nunosousa/SCART-switcher/CAD/fan-4010-orion-fan-od4010-24hb01a-1.snapshot.2/Screenshot 2024-12-19 at 11.23.29 PM.png

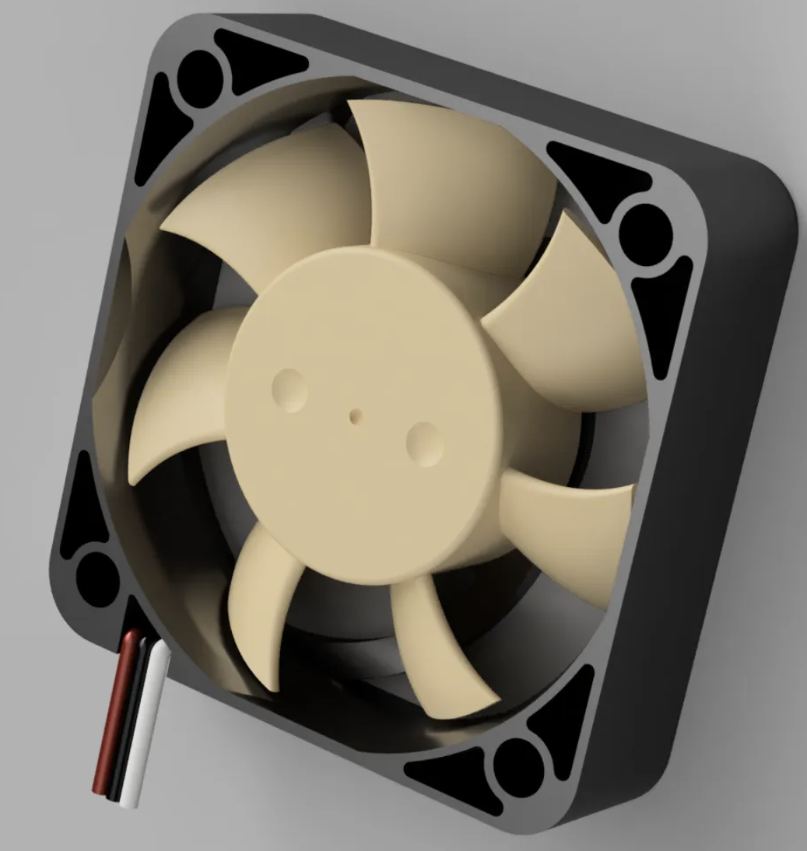
CAD/fan-4010-orion-fan-od4010-24hb01a-1.snapshot.2/Screenshot 2024-12-19 at 11.23.29 PM.png
