nunosousa/SCART-switcher/ECAD/Power_supply/Power_supply_bottom.png

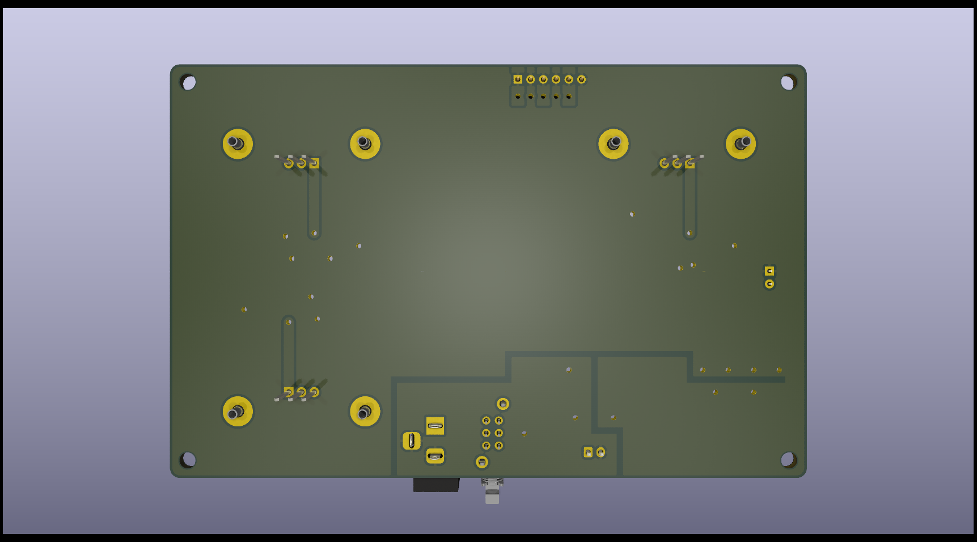
ECAD/Power_supply/Power_supply_bottom.png
