nunosousa/SCART-switcher/ECAD/SCART_switcher/SCART_switcher_bottom.png

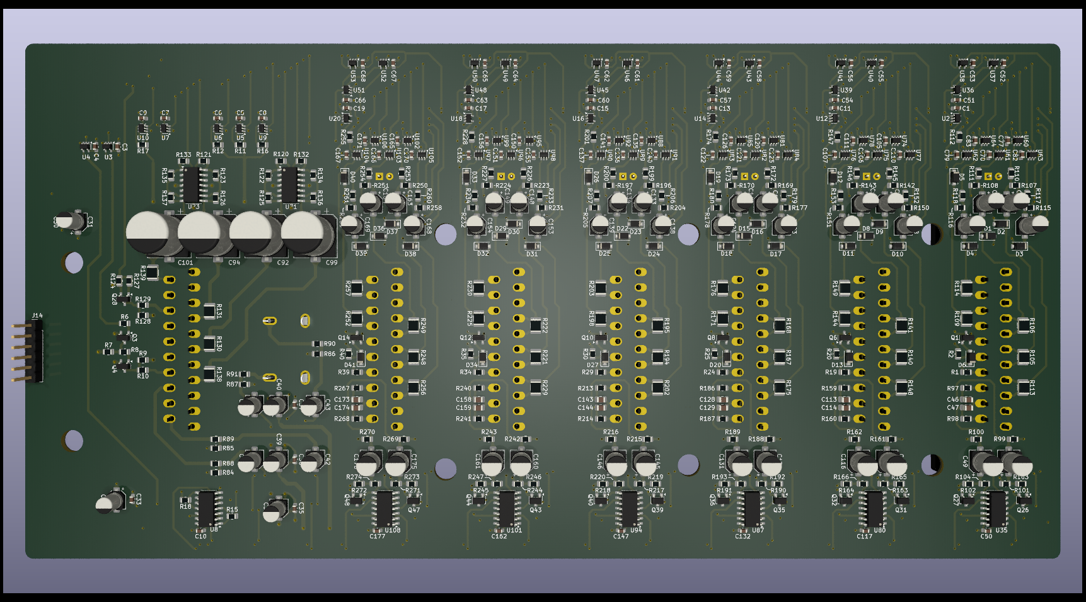
ECAD/SCART_switcher/SCART_switcher_bottom.png
