nunosousa/SCART-switcher/ECAD/SCART_switcher/LM4041.xlsx

 | Select R1 and R2 to get VO. Also get IR (V divider) and IL (load). |  |  |  | With IQ (0.1mA ≤ lQ ≤ 1mA) and VS, get Rs and Itotal. |  |  |  |  | Vref correction.
5V in, 2.5V out | Vref (V) | 1.230466 | VO (V) | 2.491189361 | IQ (A) | 0.00105 | Rs (ohm) | 522.4606912 | 523 | VY (V)* | 1.233
 | R1 (ohm) | 976 | VO error (mV) | -8.810639344 |  |  | PD (W) | 0.002615748829 |  | ΔVREF/ΔVO) (V/V)* | -0.002
 | R2 (ohm) | 1000 | IR (A) | 0.001260723361 | VS (V) | 5 |  |  |  | Desired VO (V)* | 2.5
 |  |  |  |  |  |  |  |  |  | ΔVO (V) | 1.267
 | RL (ohm) | 1000 | IL (A) | 0.002491189361 | Itotal (A) | 0.004801912721 |  |  |  | Vref (V) | 1.230466
9V in, 4.5V out | Vref (V) | 1.226466 | VO (V) | 4.505786856 | IQ (A) | 0.00105 | Rs (ohm) | 682.7813485 | 681 | VY (V)* | 1.233
 | R1 (ohm) | 374 | VO error (mV) | 5.786855615 |  |  | PD (W) | 0.004731076198 |  | ΔVREF/ΔVO) (V/V)* | -0.002
 | R2 (ohm) | 1000 | IR (A) | 0.003279320856 | VS (V) | 9 |  |  |  | Desired VO (V)* | 4.5
 |  |  |  |  |  |  |  |  |  | ΔVO (V) | 3.267
 | RL (ohm) | 2000 | IL (A) | 0.002252893428 | Itotal (A) | 0.006582214283 |  |  |  | Vref (V) | 1.226466
 | OK |  |  |  |  |  |  |  |  | OK
 |  |  |  |  |  |  |  |  |  |  |  | *See LM4041 ADJ datasheet.
