nunosousa/SCART-switcher/CAD/5mm standoff.FCStd

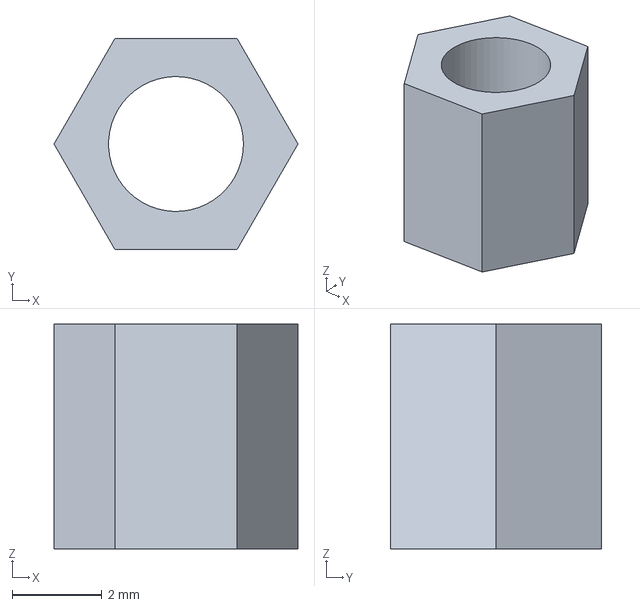
[picture p6: CAD file, 2025-02-28]
CAD/5mm standoff.FCStd
5.43 x 4.70 x 5.00 mm
