nunosousa/SCART-switcher/CAD/fan-4010-orion-fan-od4010-24hb01a-1.snapshot.2/fan-4010-orion-fan-od4010-24hb01a.step

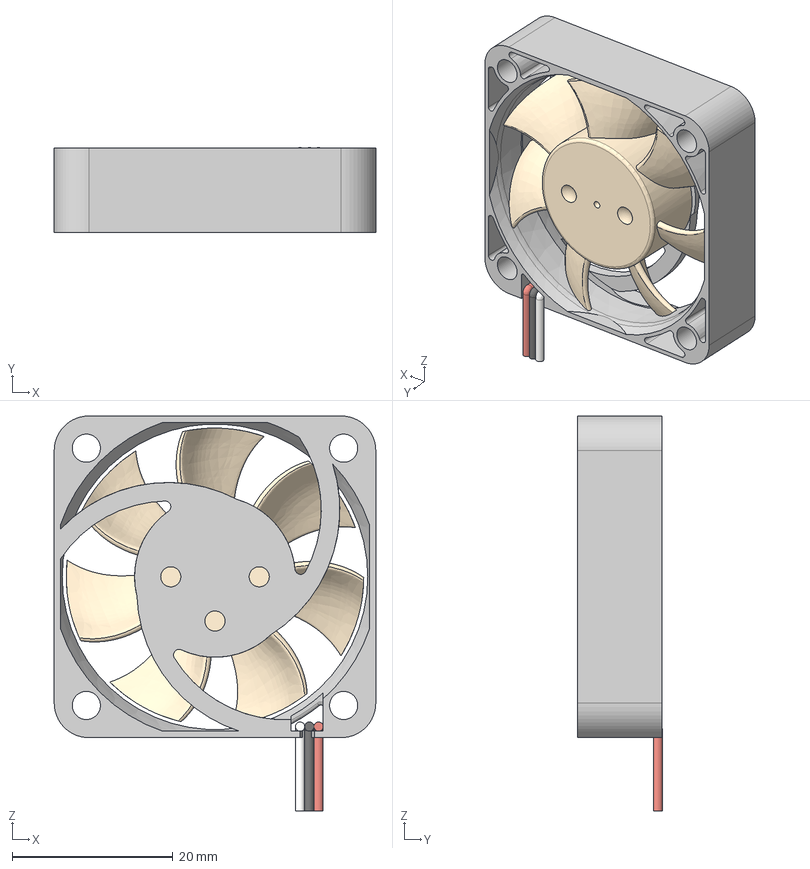
[picture p7: CAD file, 2025-02-23]
CAD/fan-4010-orion-fan-od4010-24hb01a-1.snapshot.2/fan-4010-orion-fan-od4010-24hb01a.step
40.0 x 10.6 x 49.1 mm
Orion Blades_40x40 v3
Wire-Red
Wire-Black
Wire-White
