nunosousa/SCART-switcher/ECAD/Power_supply/Power_supply.step

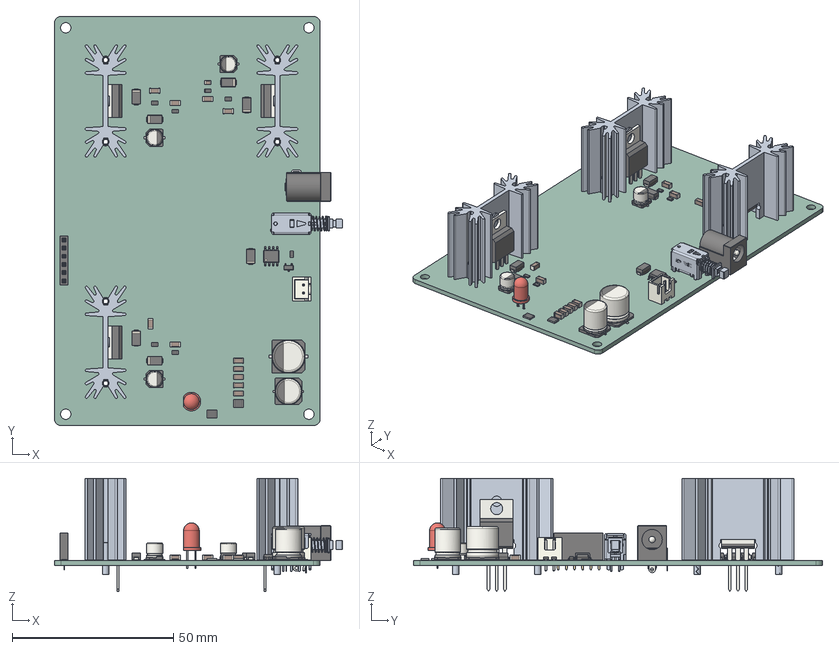
[picture p8: CAD file, 2025-02-27]
ECAD/Power_supply/Power_supply.step
89.4 x 127.0 x 35.1 mm
C_1206_3216Metric x 11
D_SMA x 7
SOIC_8_39x49mm_P127mm
R_0805_2012Metric x 7
CP_Elec_5x54 x 3
JST_B2B_XH_A
R_1210_3225Metric x 2
LED_D5.0mm
PinSocket_1x06_P2.54mm_Vertical
CP_Elec_10x105
SOT_23
TO-220-3_Vertical x 3
=>[0:1:1:2] x 3
=>[0:1:1:4] x 3
=>[0:1:1:6] x 3
C_0805_2012Metric
BarrelJack_Horizontal
CP_Elec_8x10
_autosave-Power_supply_PCB
