nunosousa/SCART-switcher/ECAD/SCART_switcher/SCART_switcher.step

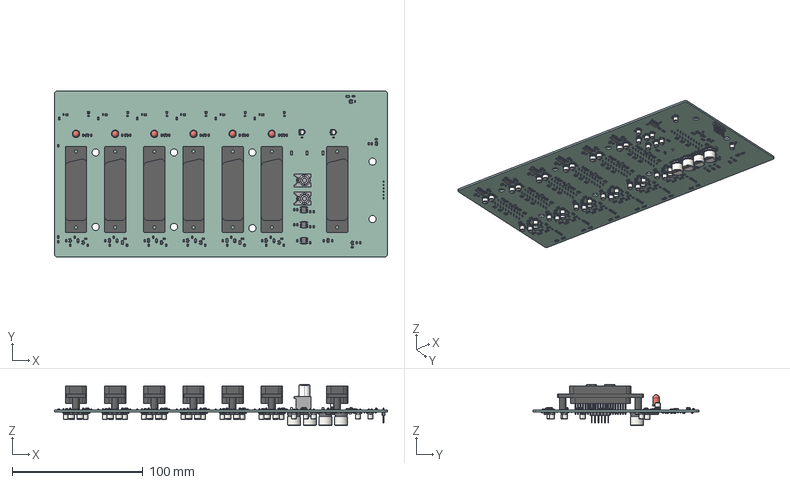
[picture p9: CAD file, 2025-02-27]
ECAD/SCART_switcher/SCART_switcher.step
255.0 x 127.0 x 31.7 mm
R_0805_2012Metric x 219
D_SOD_123F x 43
SOT_23 x 28
C_1206_3216Metric x 4
SOT_353_SC_70_5 x 38
SOT_23_5
C_0603_1608Metric x 88
SOIC_8_39x49mm_P127mm x 3
LED_D5.0mm x 6
SOT-23-3 x 2
CP_Elec_4x54 x 11
R_1210_3225Metric x 34
CP_Elec_4x58 x 24
SOT_363_SC_70_6 x 35
CP_Elec_10x105 x 4
SC_59 x 12
CP_Elec_5x54 x 12
C_0805_2012Metric x 12
SOIC_14_39x87mm_P127mm x 9
PinHeader_1x06_P254mm_Vertical
SCART_switcher_PCB
