nunosousa/SCART-switcher/CAD/35mm standoff.FCStd

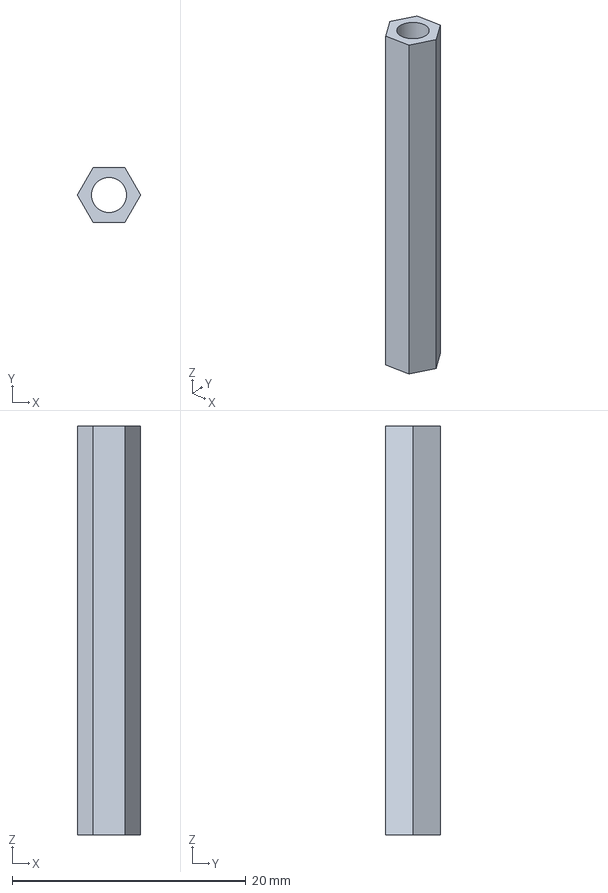
[picture p10: CAD file, 2025-02-25]
CAD/35mm standoff.FCStd
5.43 x 4.70 x 35.0 mm
