nunosousa/SCART-switcher/CAD/SCART connector with m holes (female)-Body.step

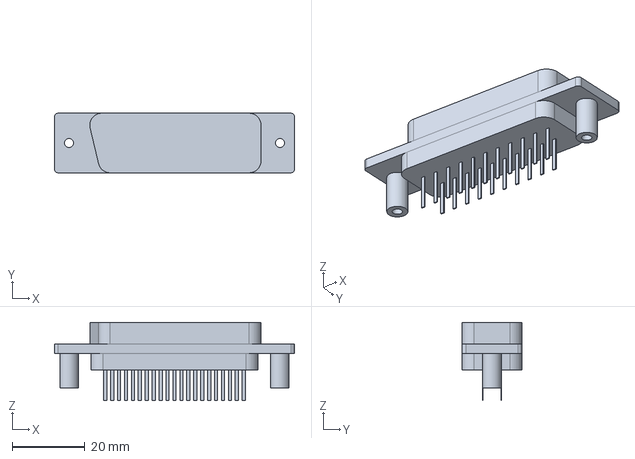
[picture p11: CAD file, 2025-02-23]
CAD/SCART connector with m holes (female)-Body.step
66.0 x 16.4 x 21.5 mm
