nunosousa/SCART-switcher/CAD/sk_104_25.4_stc.igs

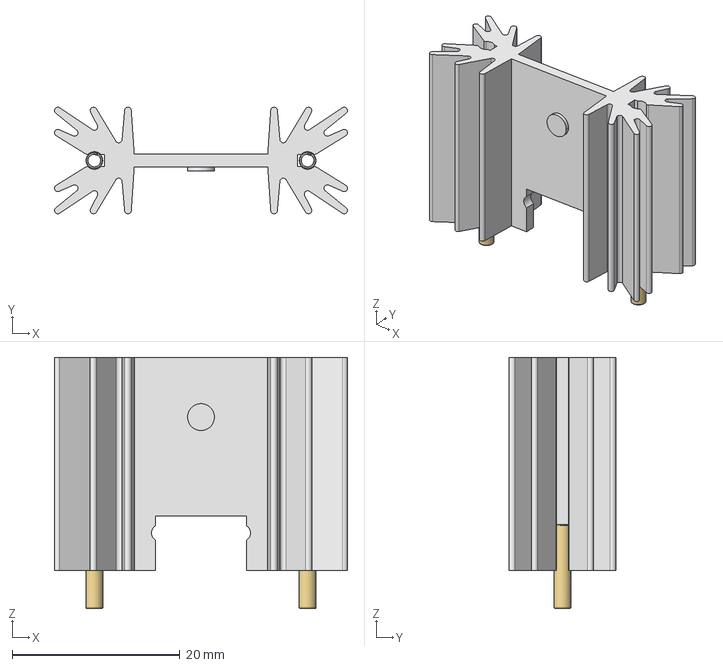
[picture p12: CAD file, 2025-02-16]
CAD/sk_104_25.4_stc.igs
34.9 x 12.7 x 29.9 mm
