nunosousa/SCART-switcher/CAD/sk_104_25.4_stic.igs

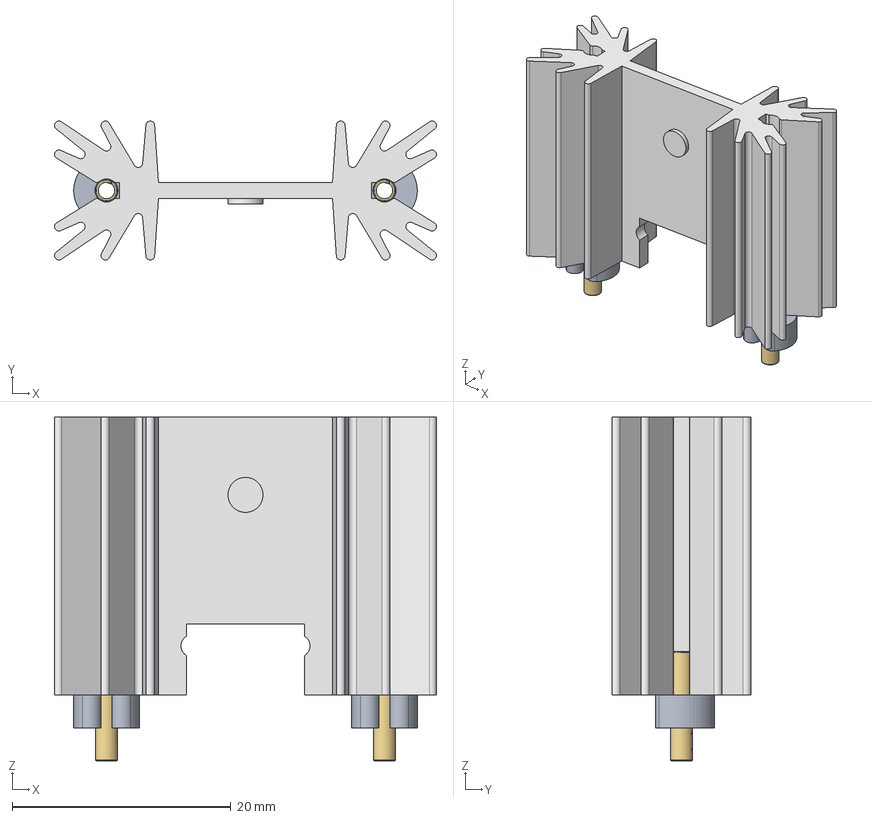
[picture p13: CAD file, 2025-02-16]
CAD/sk_104_25.4_stic.igs
34.9 x 12.7 x 31.4 mm
