nunosousa/SCART-switcher/CAD/SCART connector (female)-Body.iges

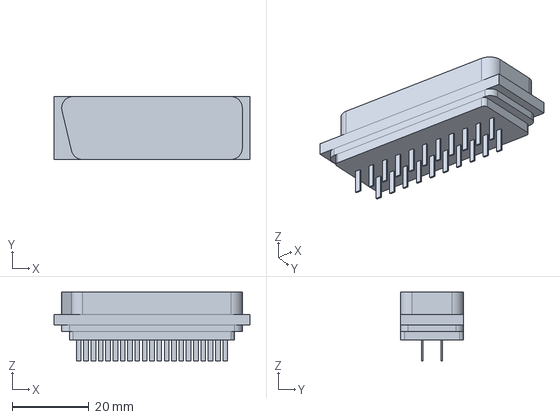
[picture p14: CAD file, 2023-08-15]
CAD/SCART connector (female)-Body.iges
51.0 x 16.4 x 17.9 mm
