nunosousa/SCART-switcher/(list of files, cad)

Other CAD files:
CAD/SCART connector with m holes (female).FCStd
CAD/SCART connector (female).FCStd
CAD/SCART connector with m holes (female)-Body.iges
CAD/fan-4010-orion-fan-od4010-24hb01a-1.snapshot.2/fan-4010-orion-fan-od4010-24hb01a.f3d
CAD/fan-4010-orion-fan-od4010-24hb01a-1.snapshot.2/fan-4010-orion-fan-od4010-24hb01a.iges
