nunosousa/SCART-switcher/ECAD/Power_supply/Power_supply.pdf

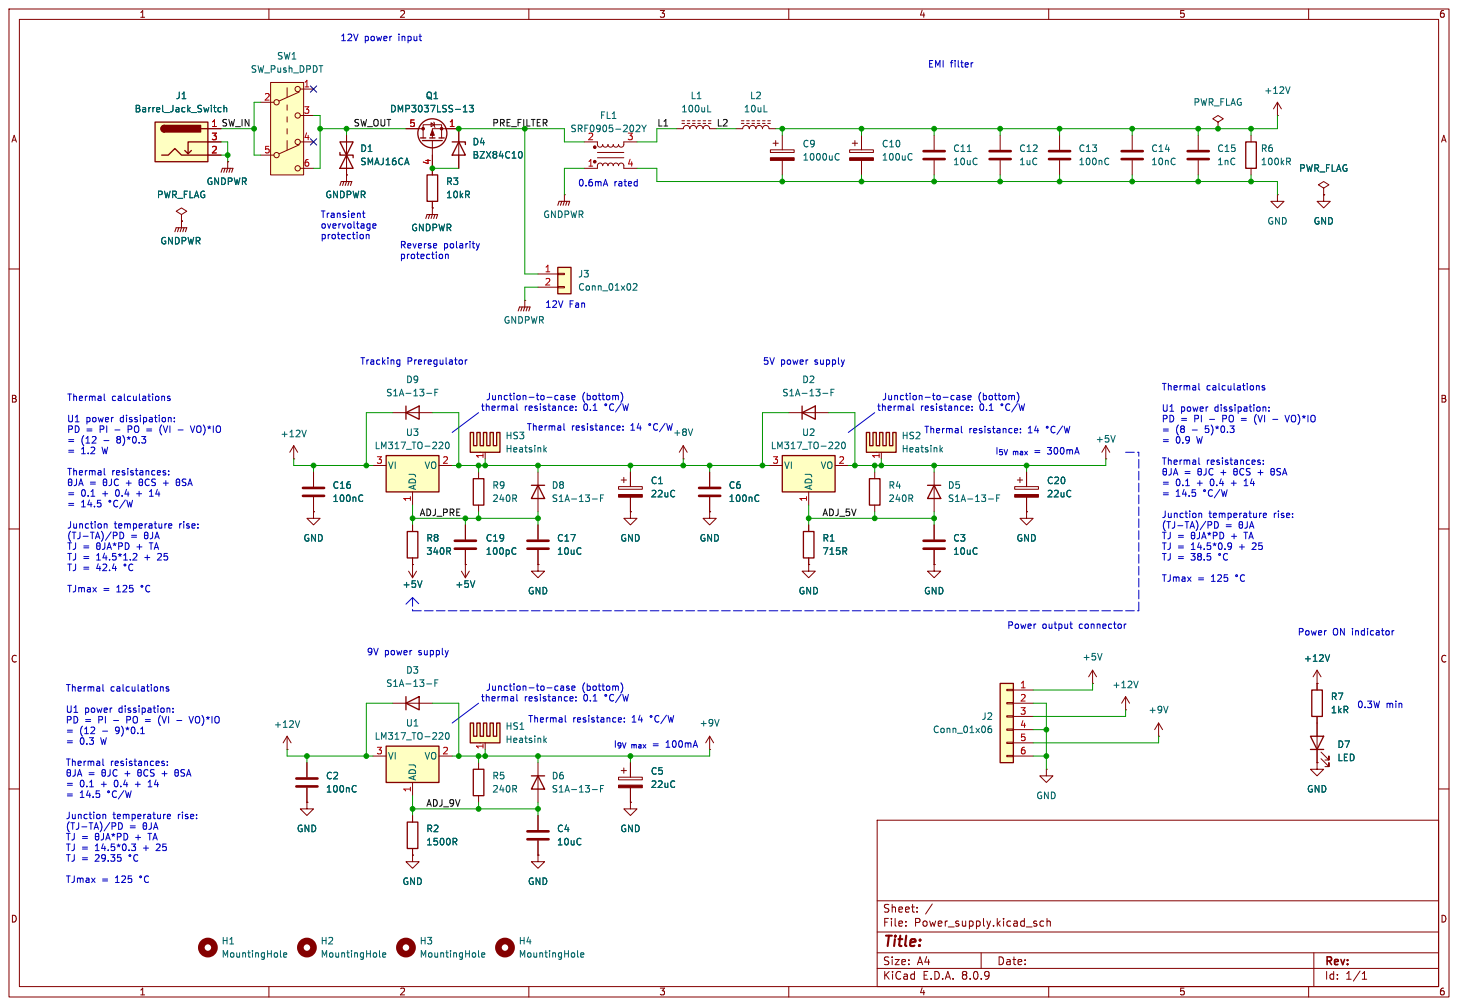
[picture p15: page 1]

5V power supply Thermal calculations U1 power dissipation: PD = PI - PO = (VI - VO)*IO

Thermal resistances: þÿ¸JA= þÿ¸JC+ þÿ¸CS+ þÿ¸SA

0.3W min Thermal calculations U1 power dissipation: PD = PI - PO = (VI - VO)*IO
