nunosousa/SCART-switcher/ECAD/SCART_switcher/SCART_switcher.pdf

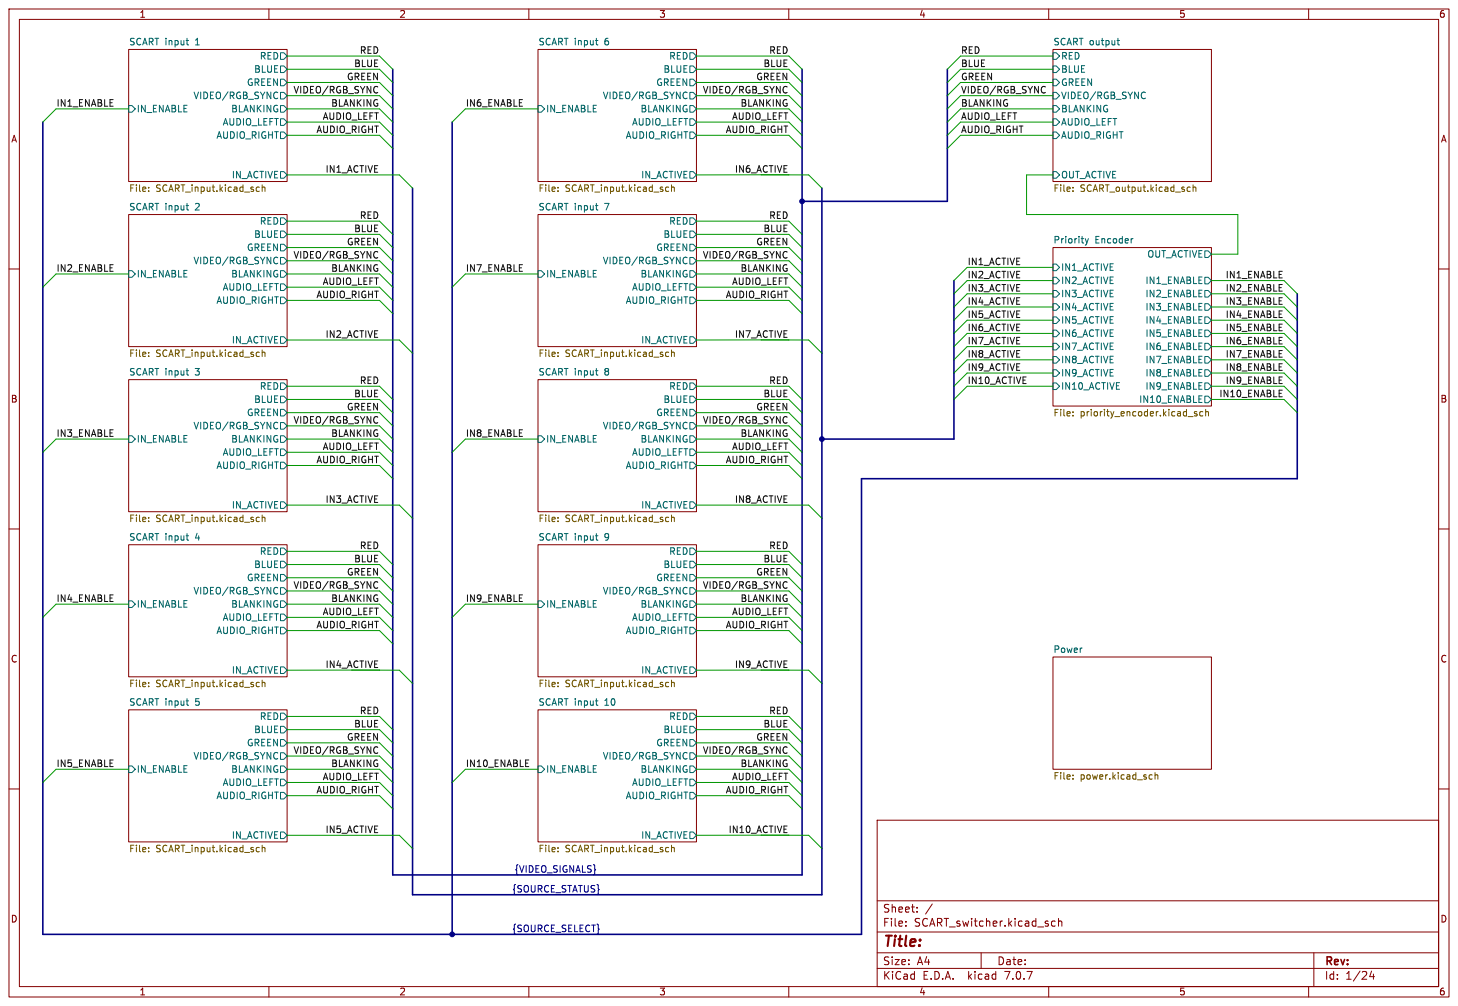
[picture p16: page 1]

SCART input 9 File: SCART_input.kicad_sch BLUE
RED

Id: 1/24 Title: File: SCART_switcher.kicad_sch Sheet: /

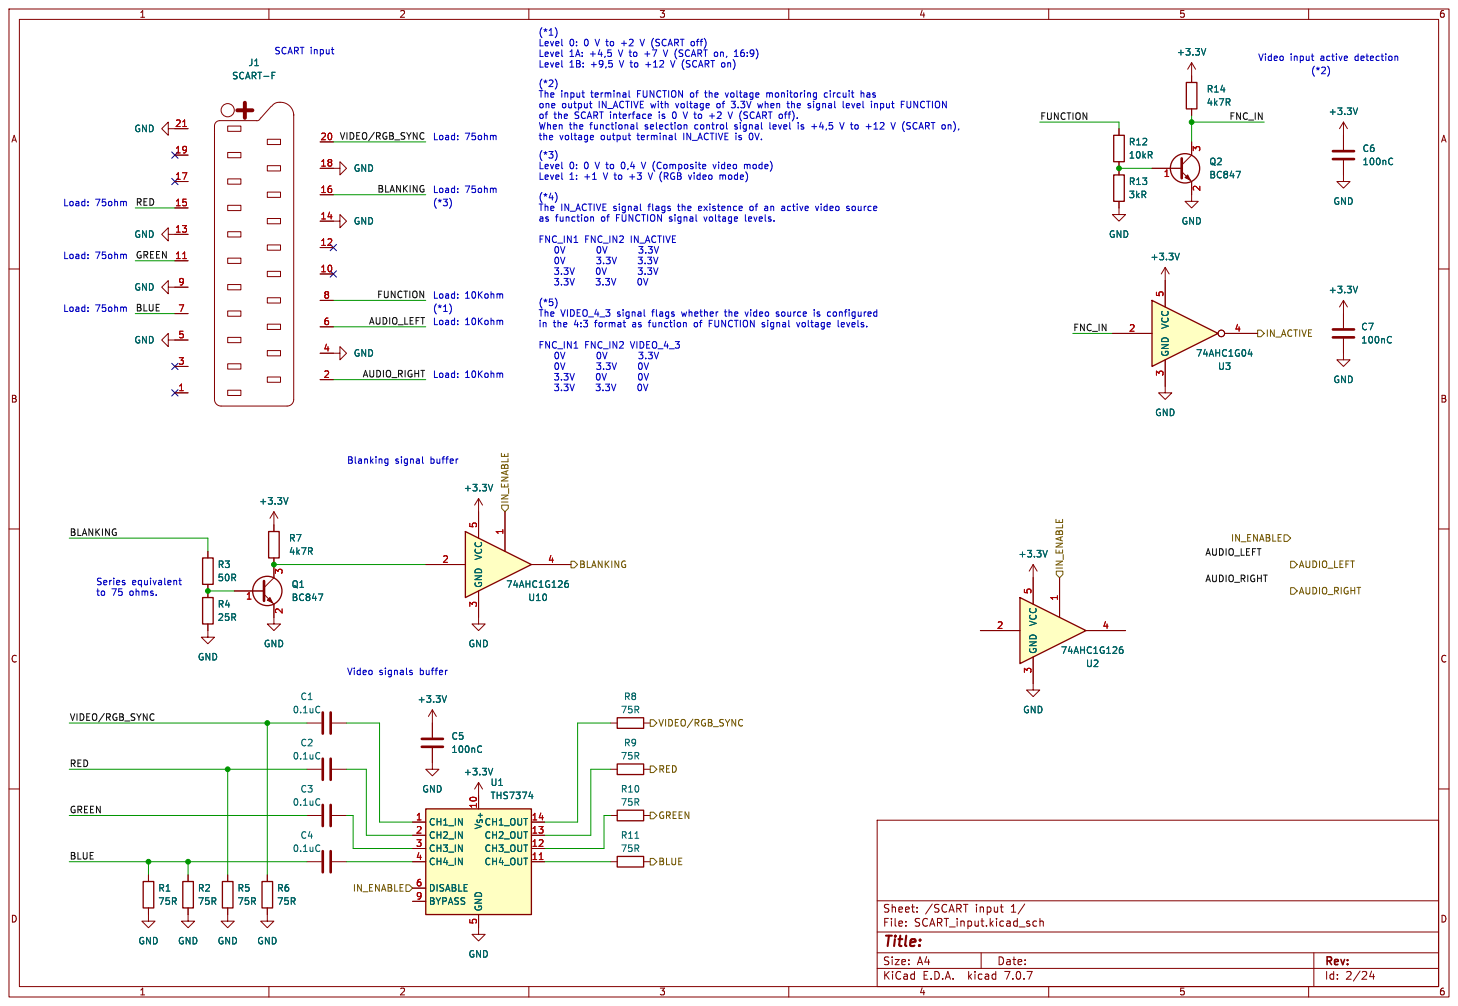
[picture p17: page 2]

(*1) Level 0: 0 V to +2 V (SCART off) Level 1A: +4,5 V to +7 V (SCART on, 16:9) Level 1B: +9,5 V to +12 V (SCART on)
(*1) Load: 75ohm

FUNCTION GREEN
+3.3V GND GND GND GND

(*5) The VIDEO_4_3 signal flags whether the video source is configured

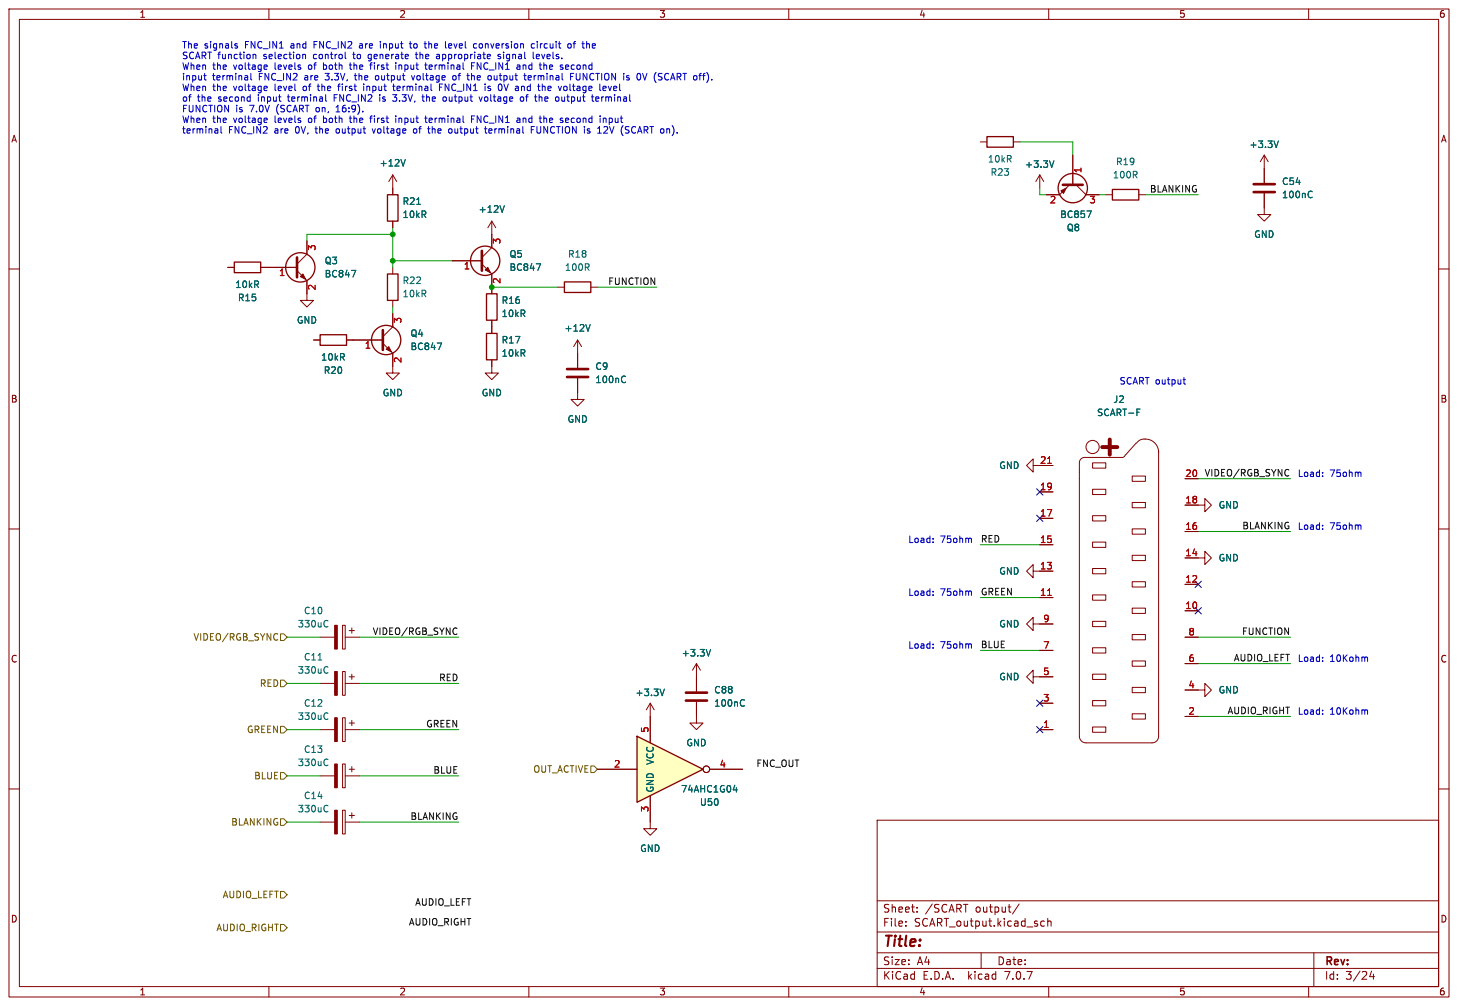
[picture p18: page 3]

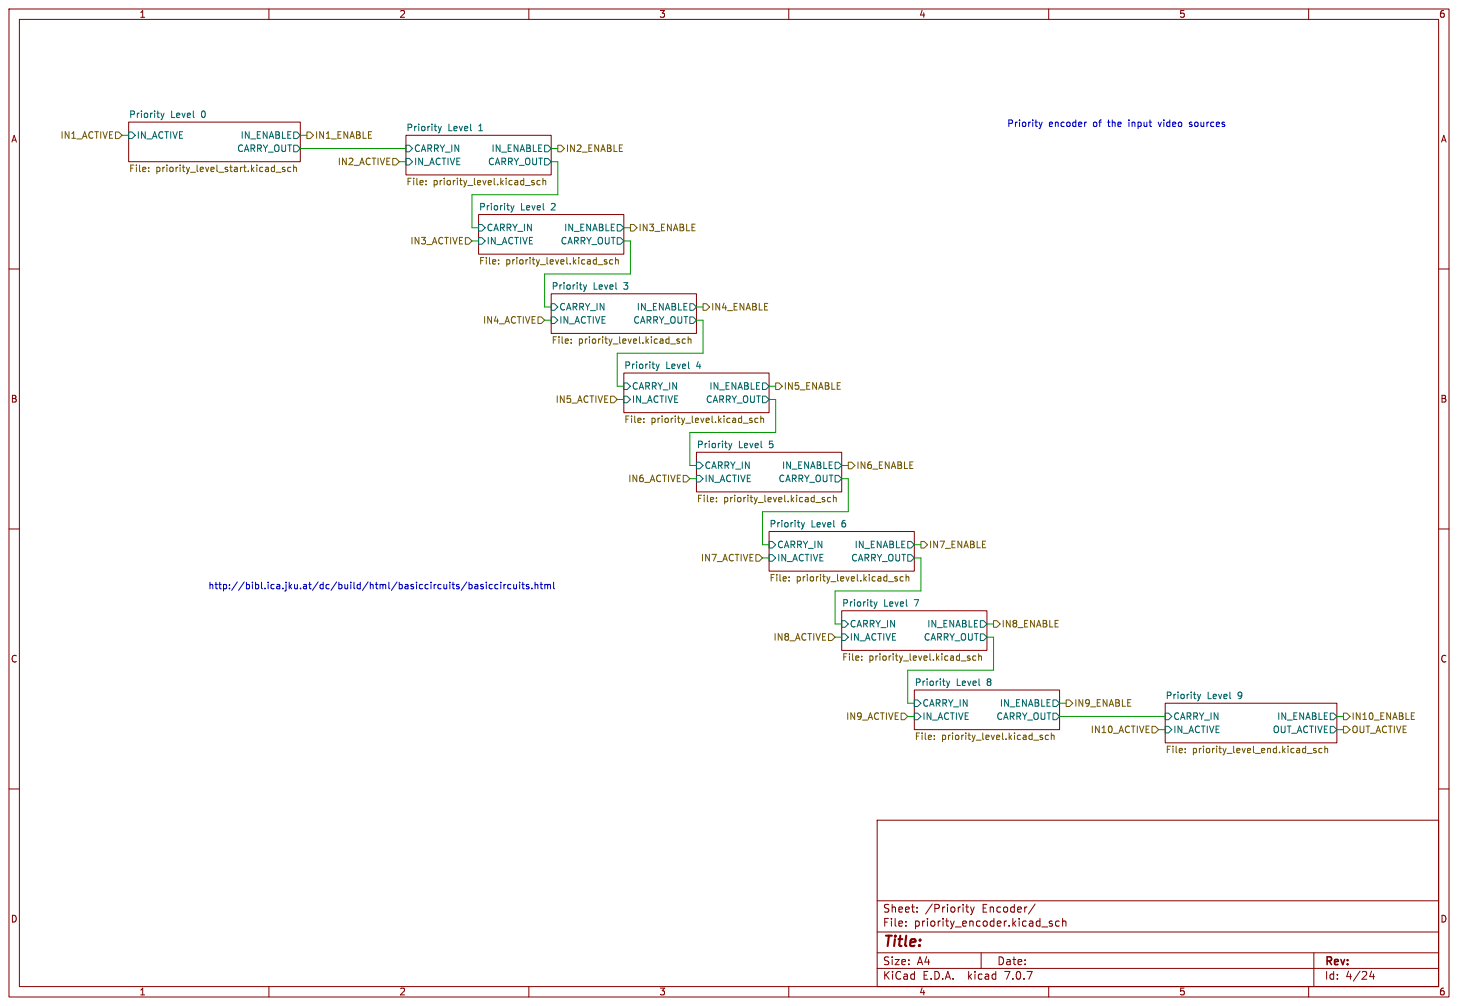
[picture p19: page 4]

http://bibl.ica.jku.at/dc/build/html/basiccircuits/basiccircuits.html

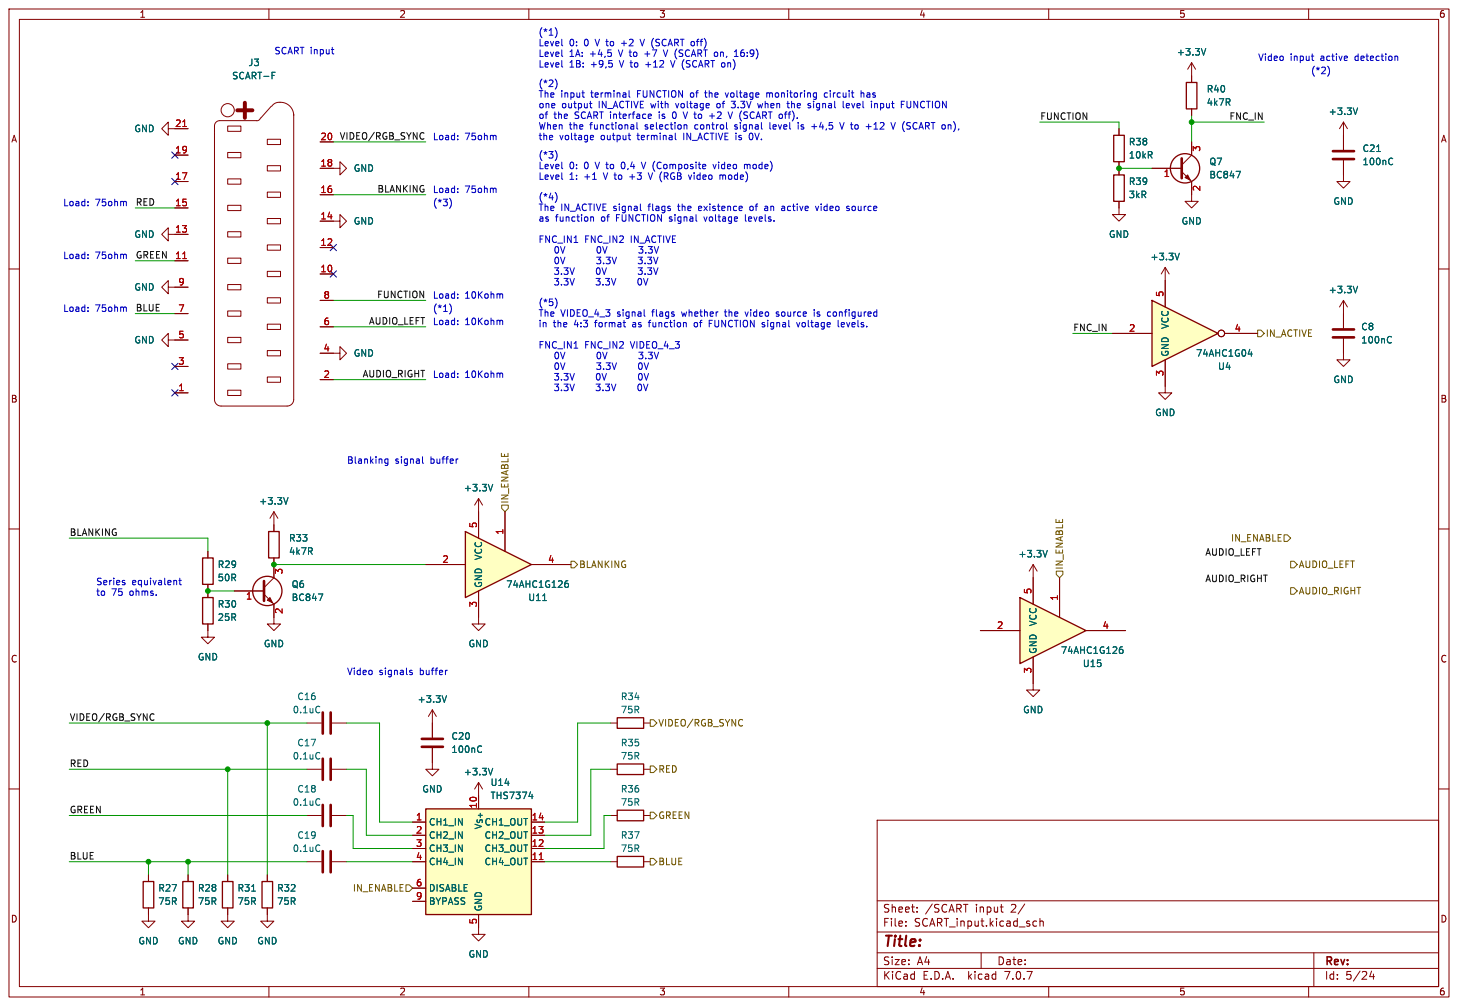
[picture p20: page 5]
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

(*5) The VIDEO_4_3 signal flags whether the video source is configured

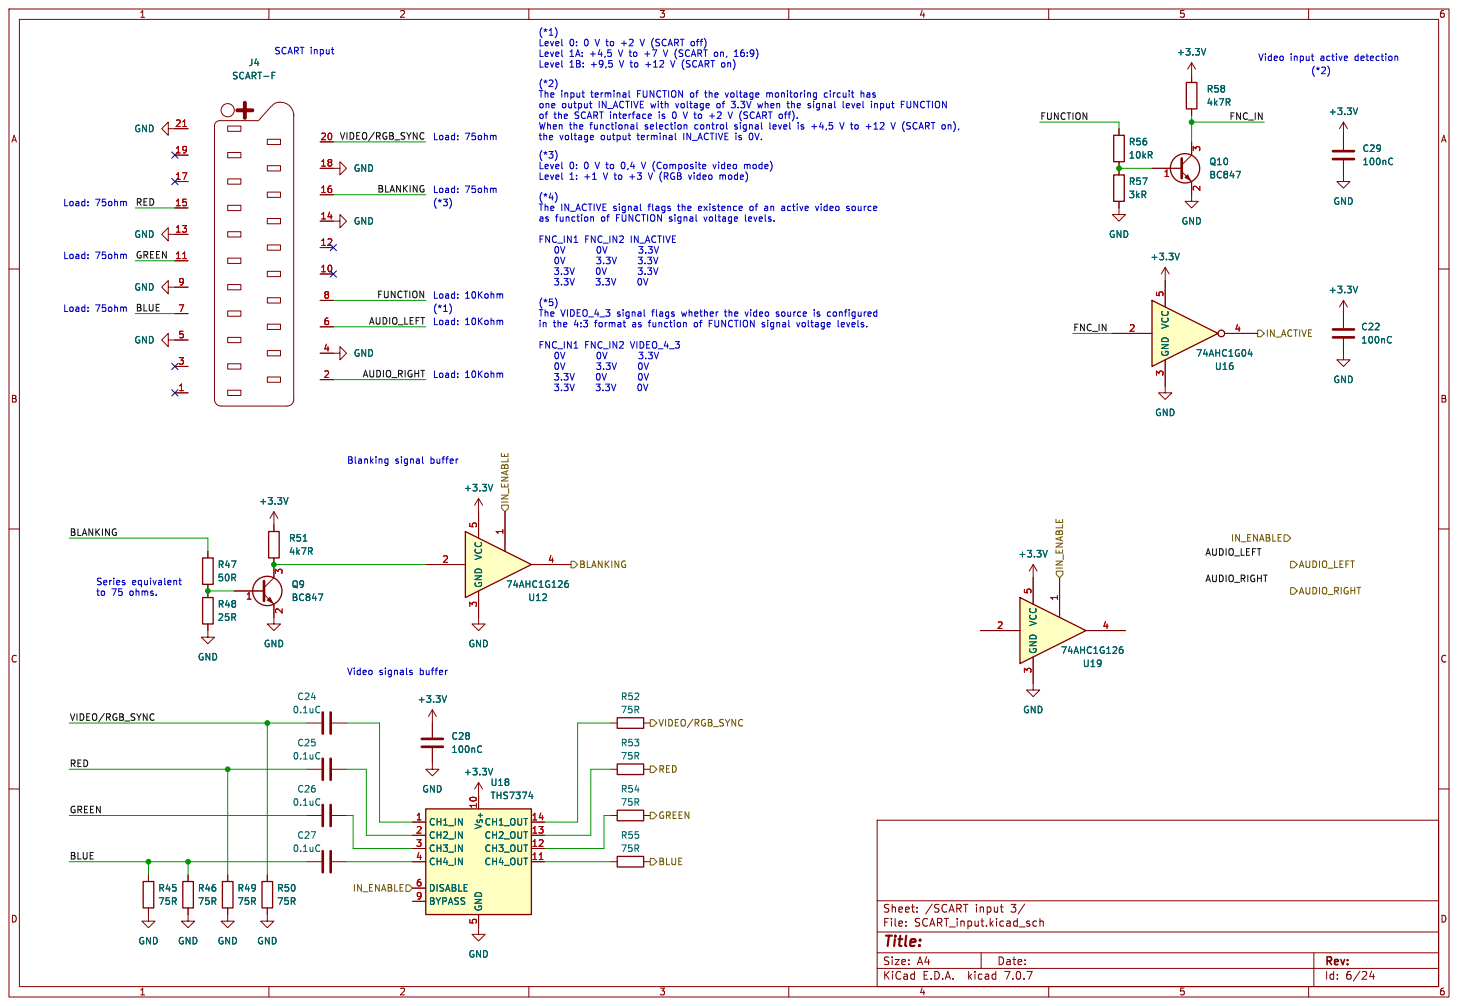
[picture p21: page 6]
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

(*5) The VIDEO_4_3 signal flags whether the video source is configured

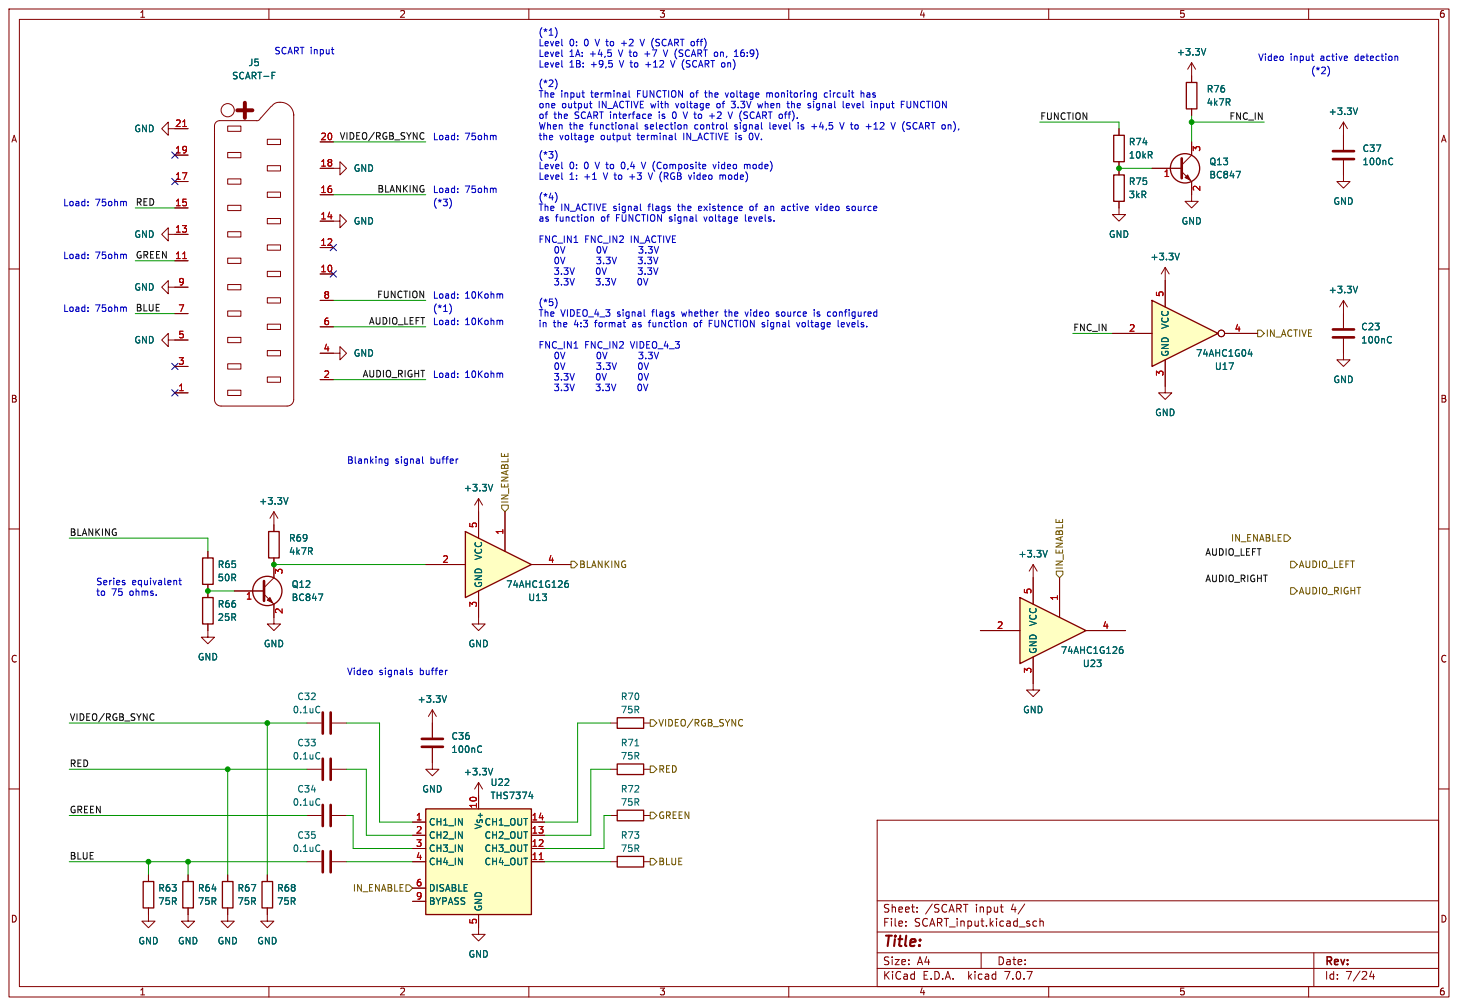
[picture p22: page 7]
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

(*5) The VIDEO_4_3 signal flags whether the video source is configured

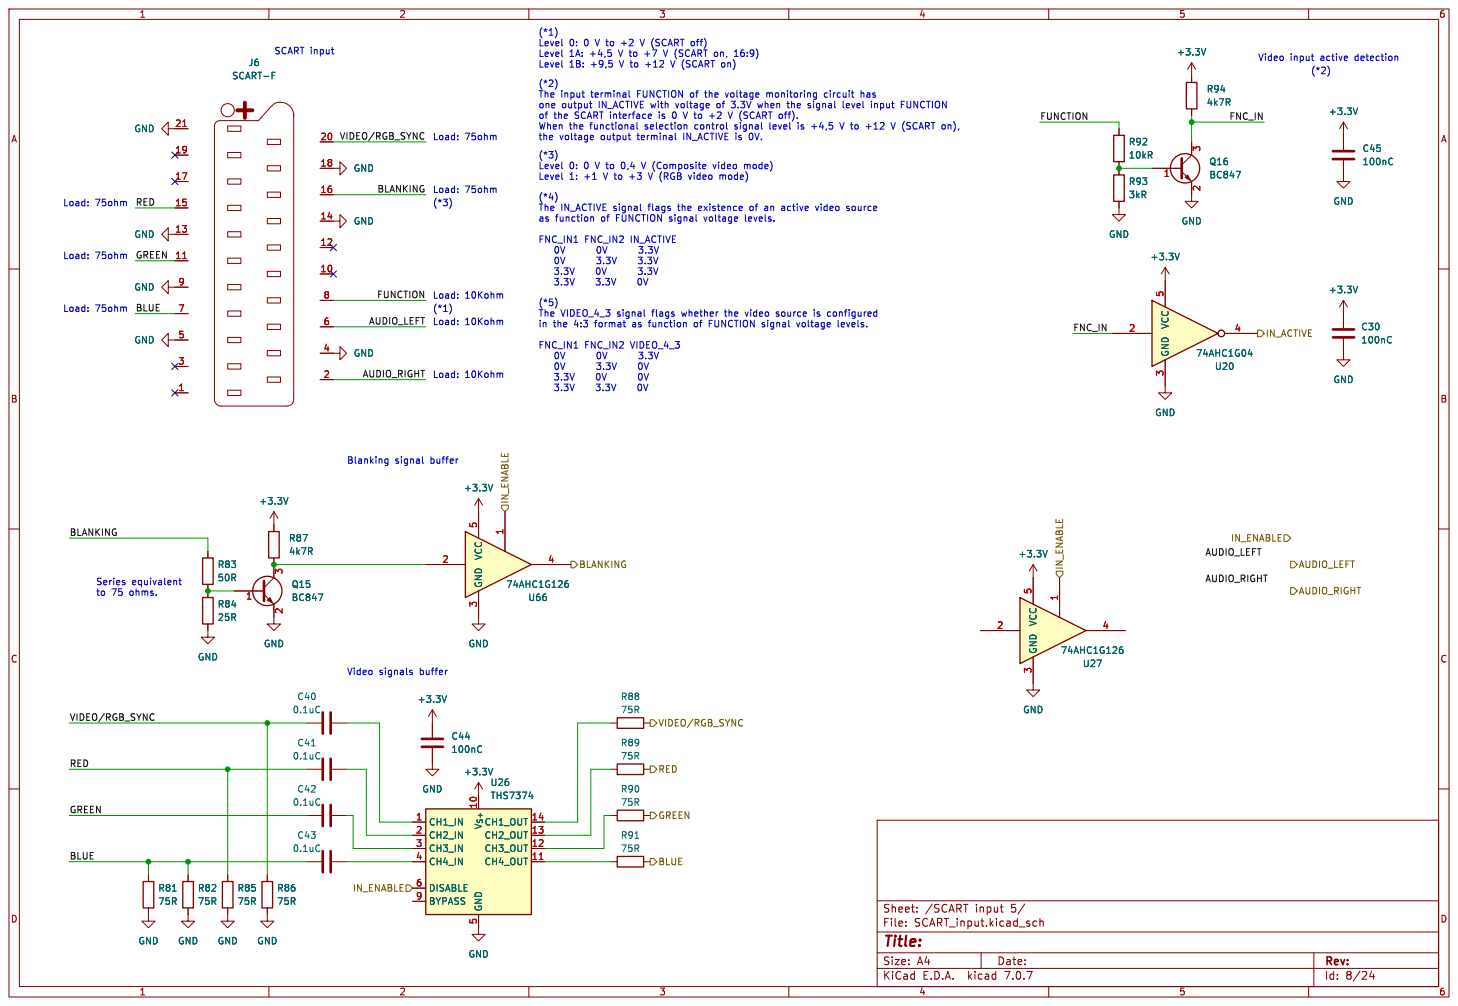
[picture p23: page 8]
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

FUNCTION GREEN
+3.3V GND GND GND GND

(*5) The VIDEO_4_3 signal flags whether the video source is configured

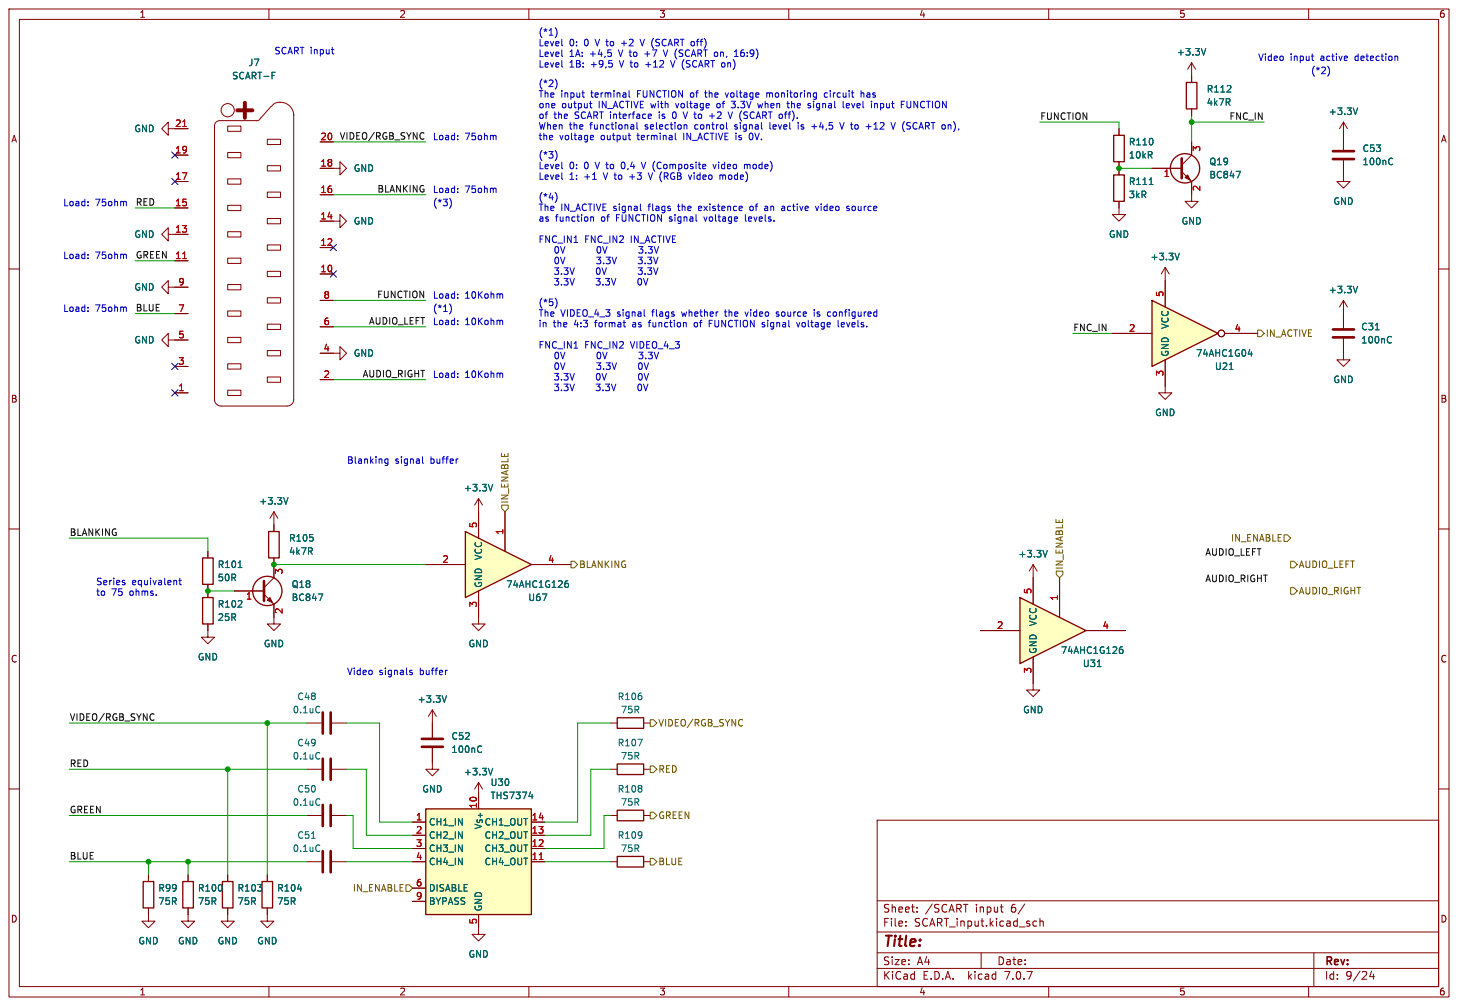
[picture p24: page 9]
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

(*5) The VIDEO_4_3 signal flags whether the video source is configured

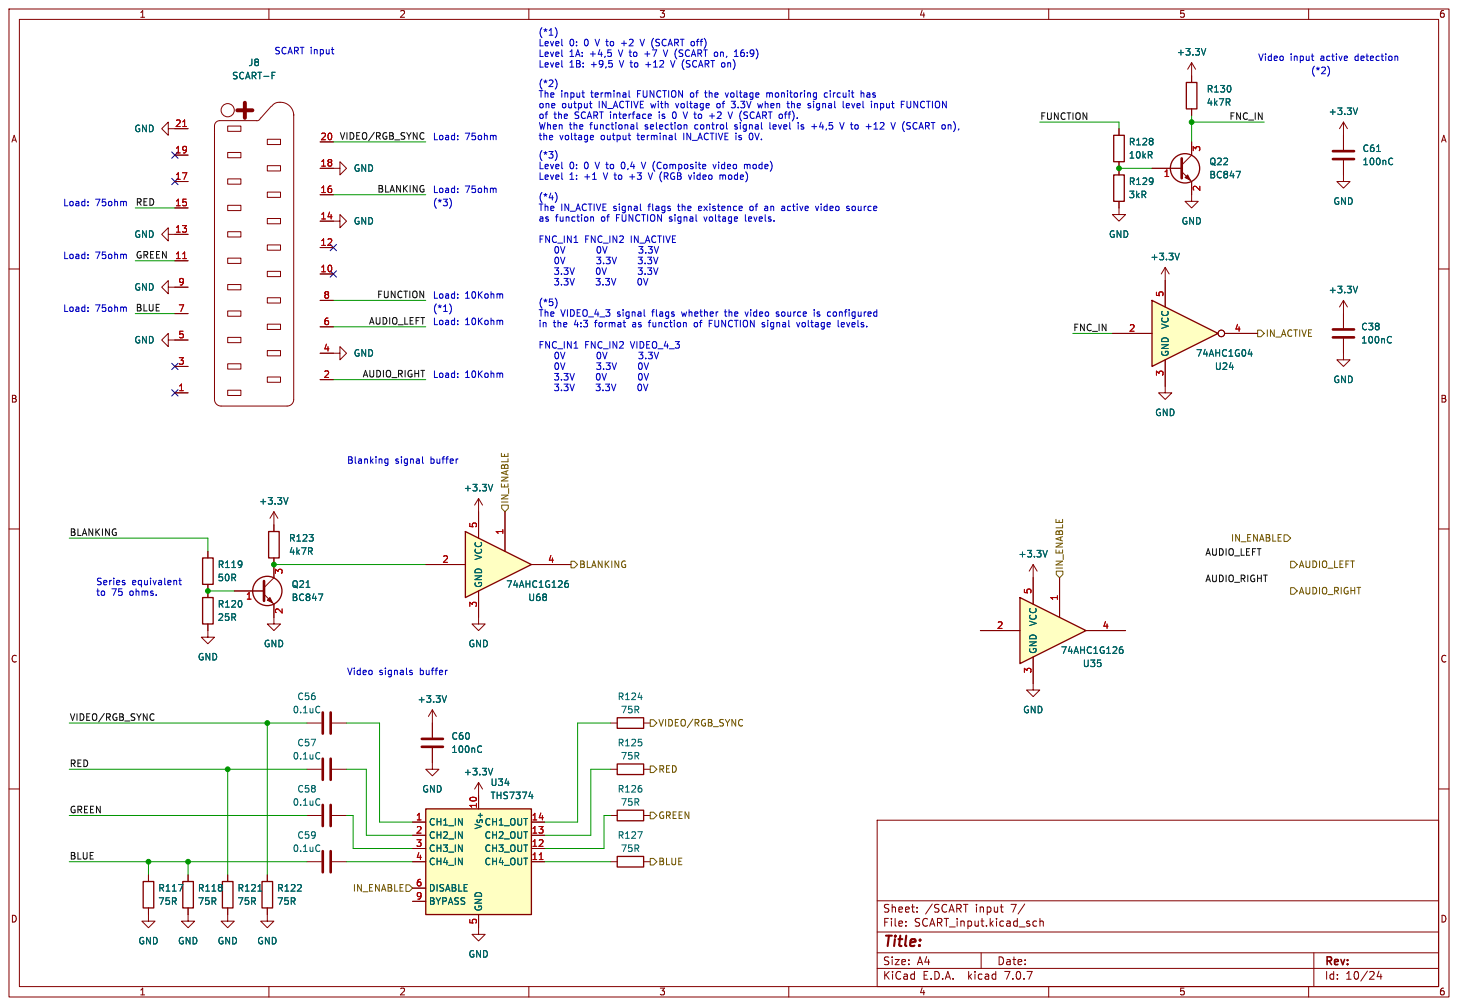
[picture p25: page 10]
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

(*5) The VIDEO_4_3 signal flags whether the video source is configured

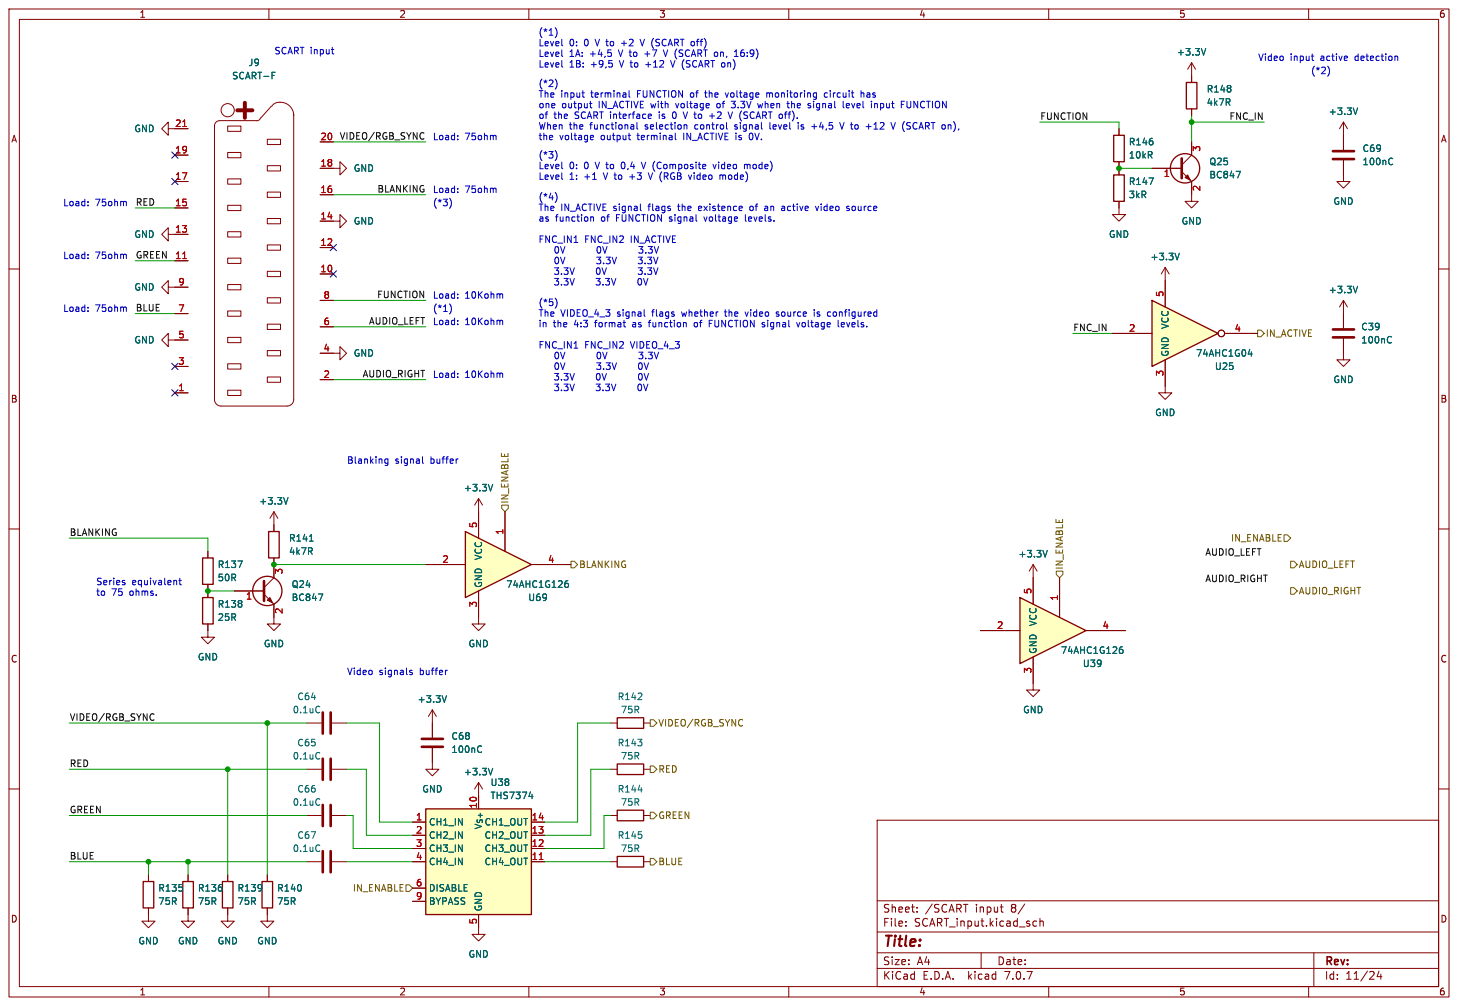
[picture p26: page 11]
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

(*5) The VIDEO_4_3 signal flags whether the video source is configured

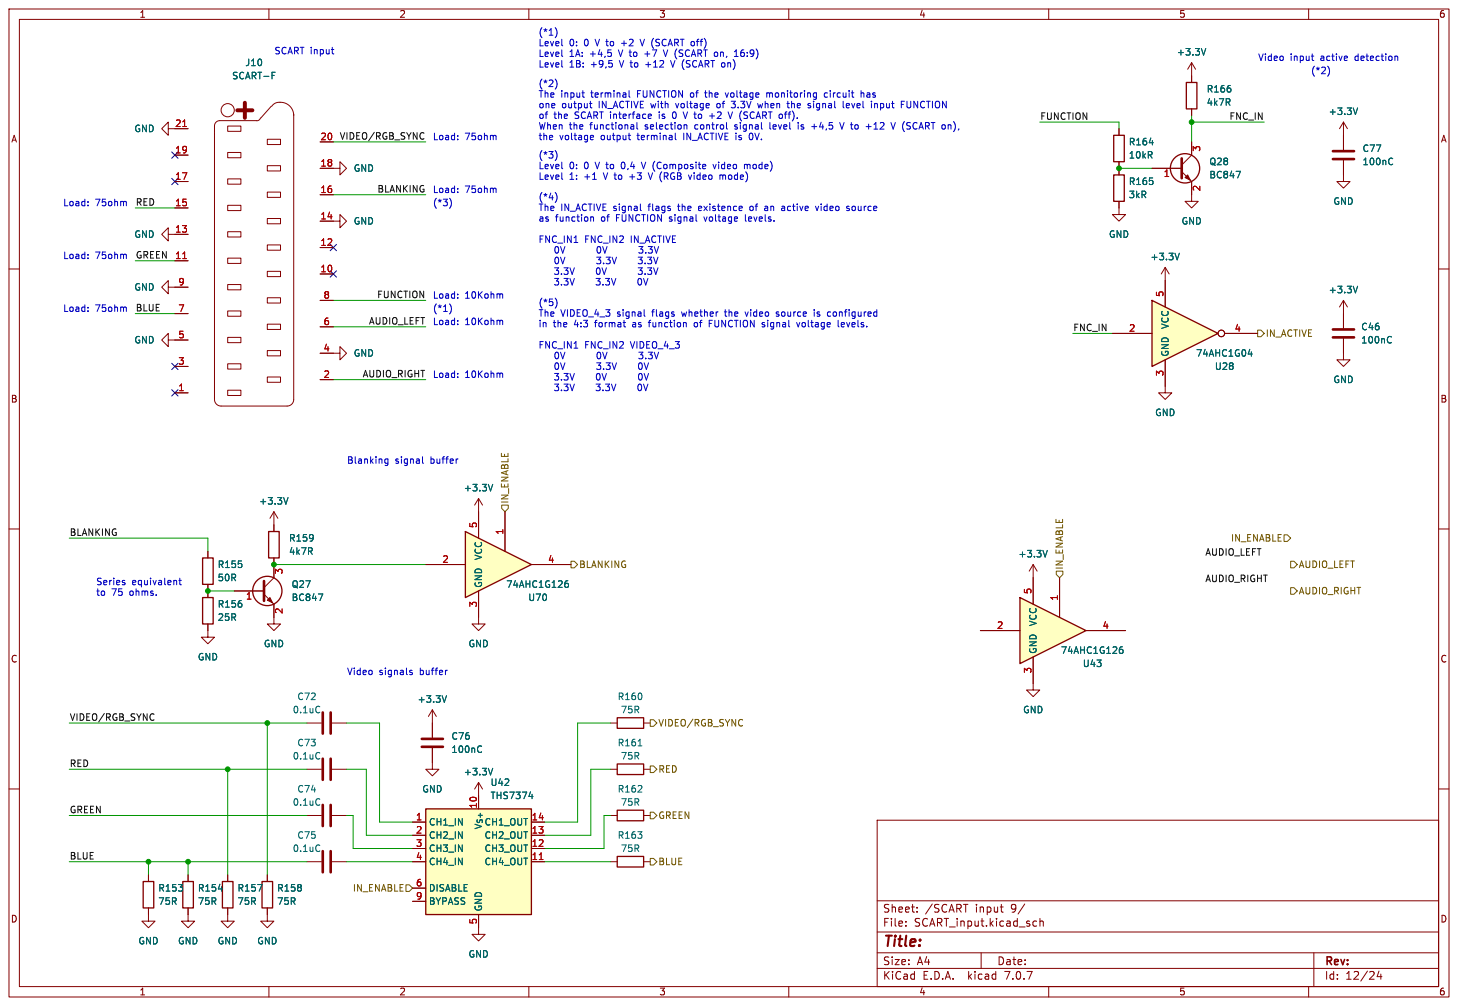
[picture p27: page 12]
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

FUNCTION GREEN
+3.3V GND GND GND GND

(*5) The VIDEO_4_3 signal flags whether the video source is configured

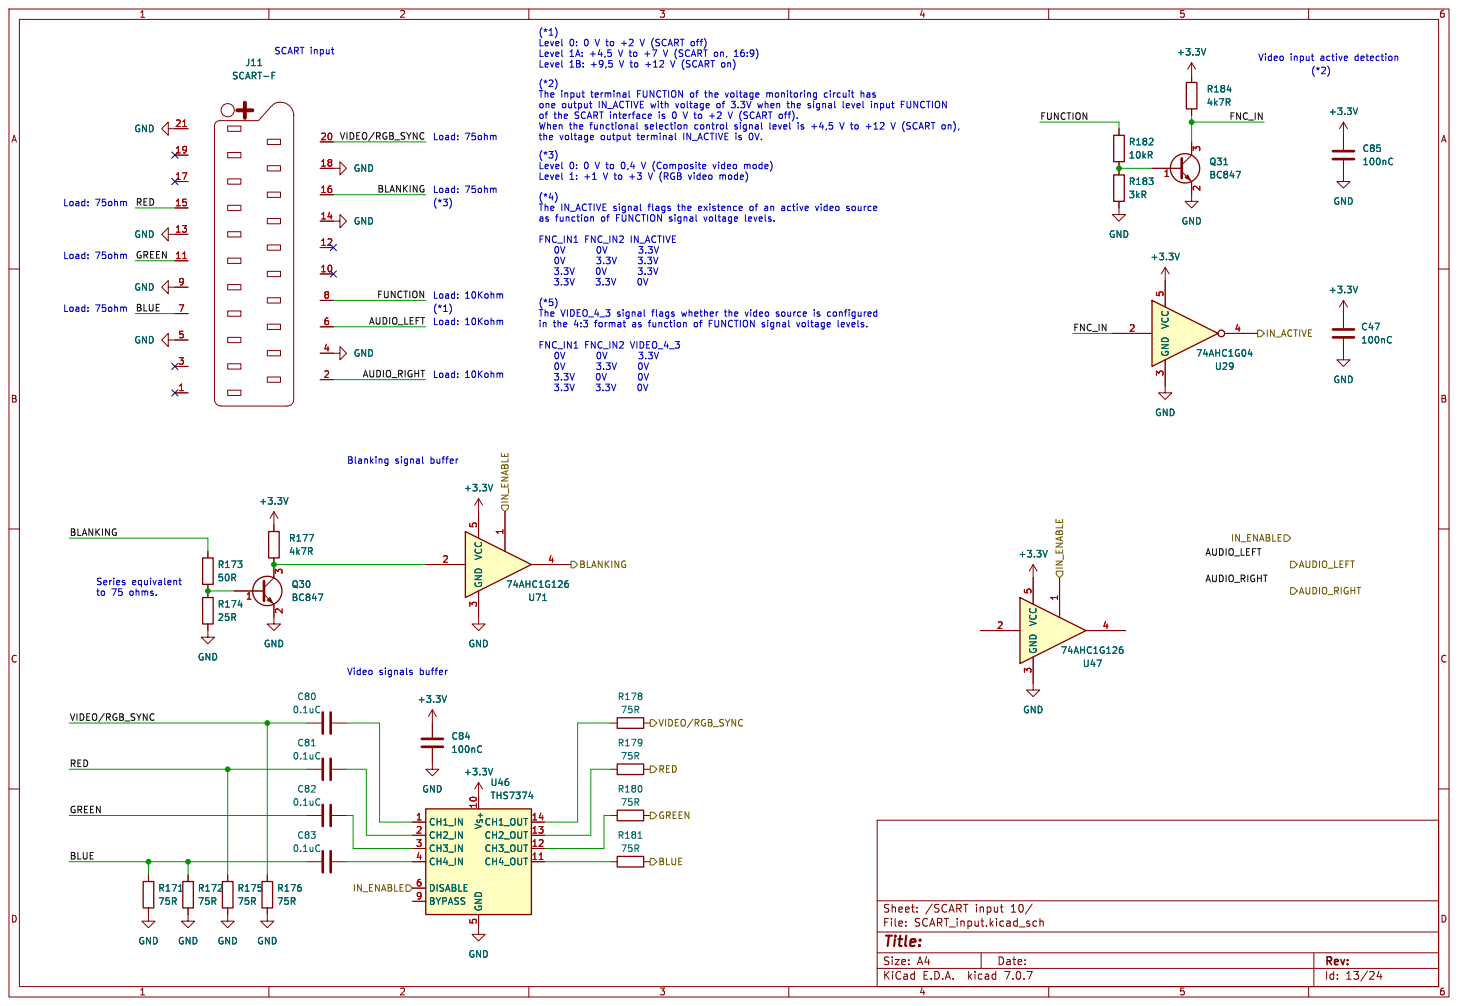
[picture p28: page 13]
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

(*5) The VIDEO_4_3 signal flags whether the video source is configured

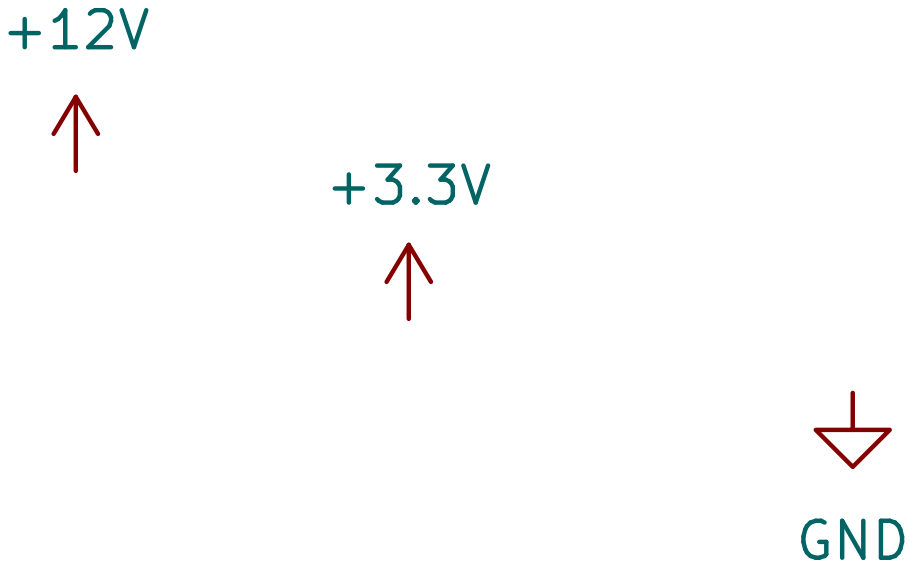
[picture p29: page 14]

Id: 14/24 Title: File: power.kicad_sch Sheet: /Power/

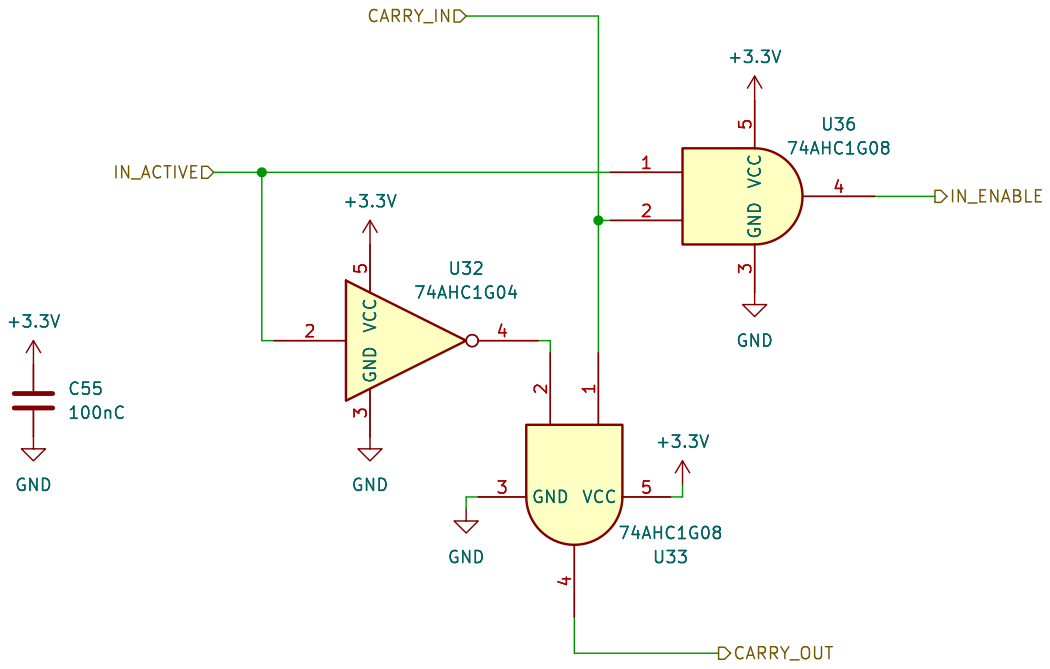
[picture p30: page 15]

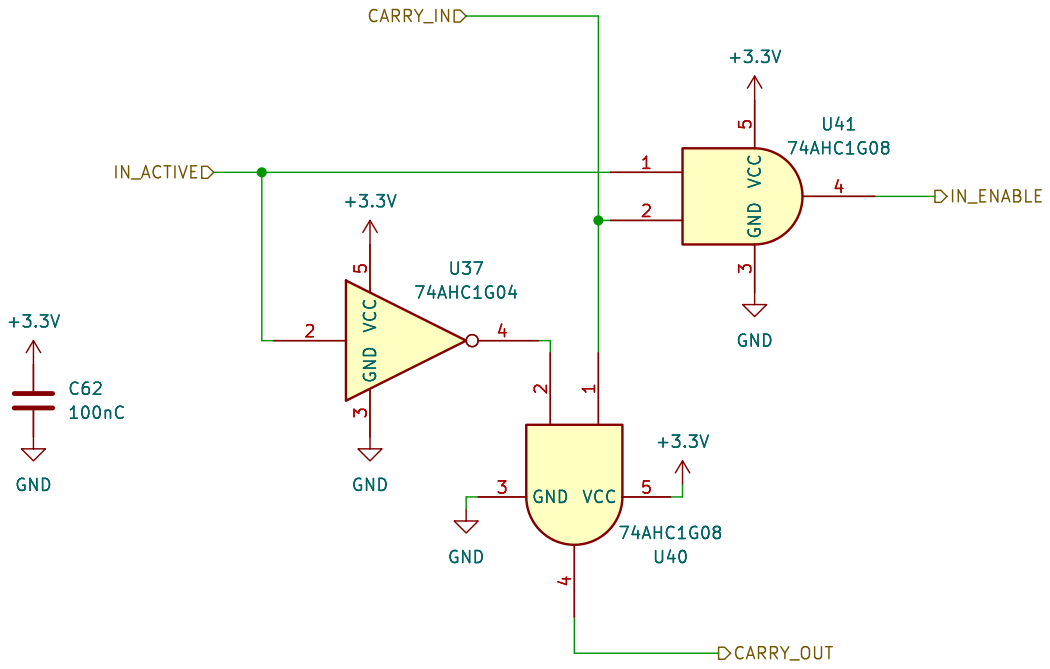
[picture p31: page 16]

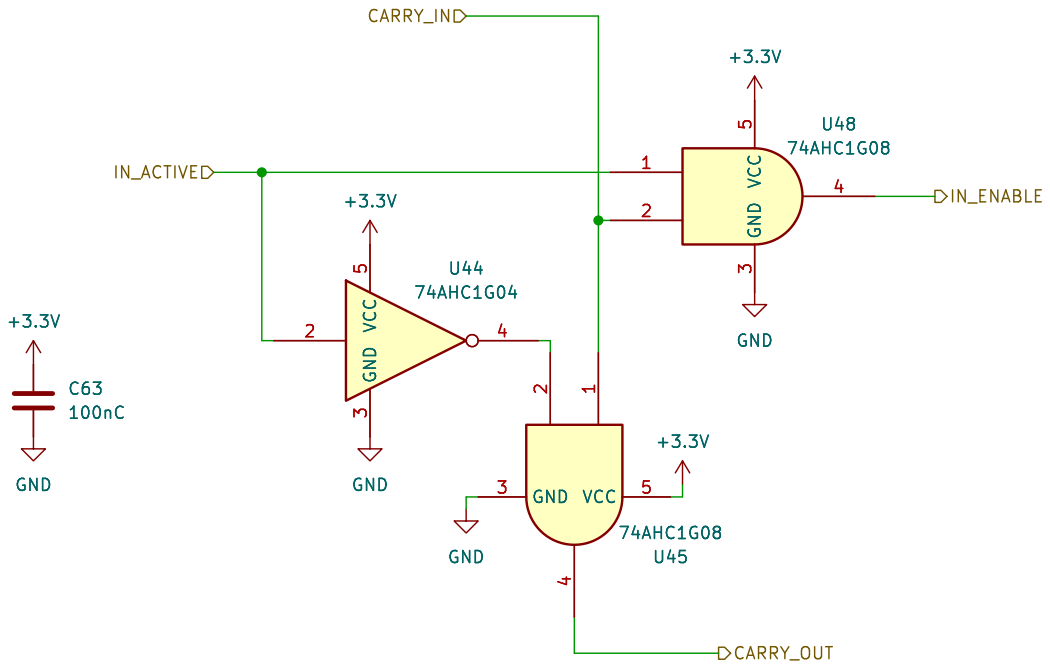
[picture p32: page 17]

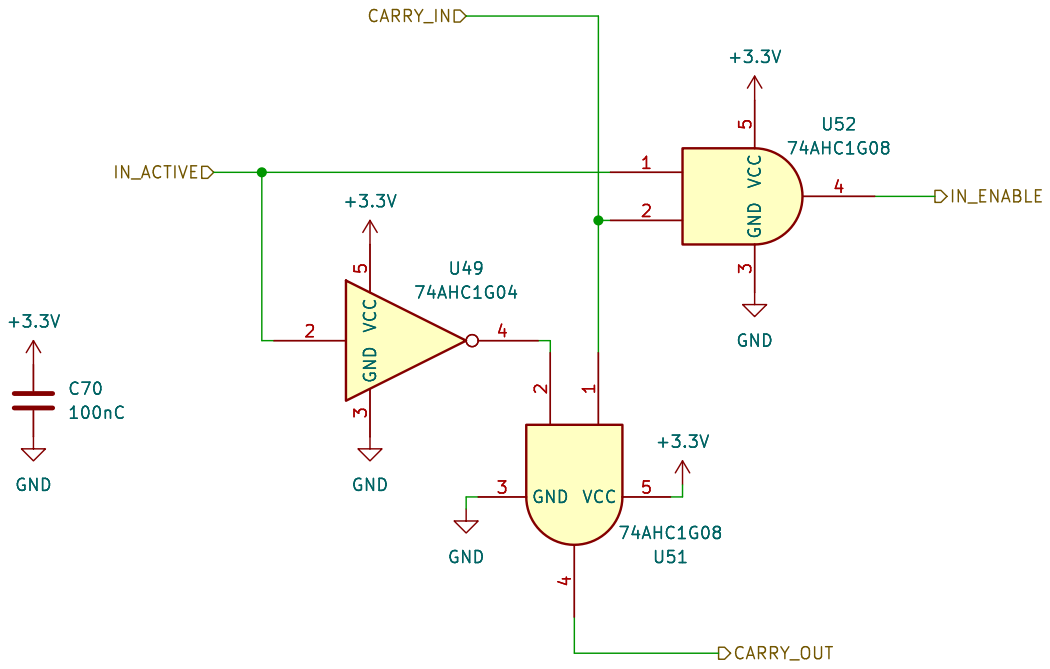
[picture p33: page 18]

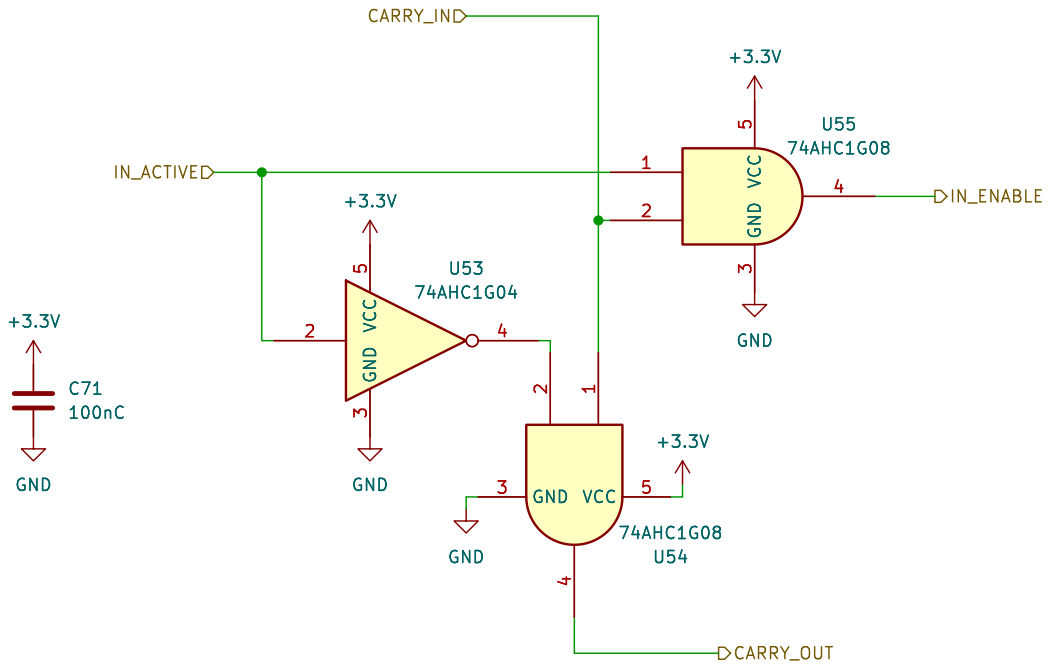
[picture p34: page 19]

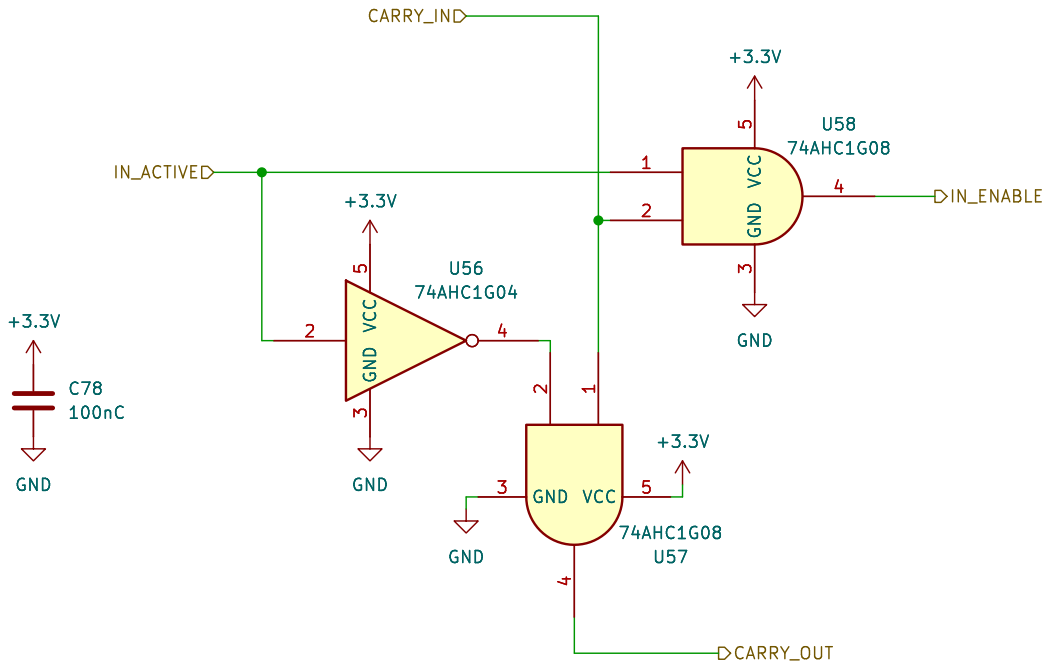
[picture p35: page 20]

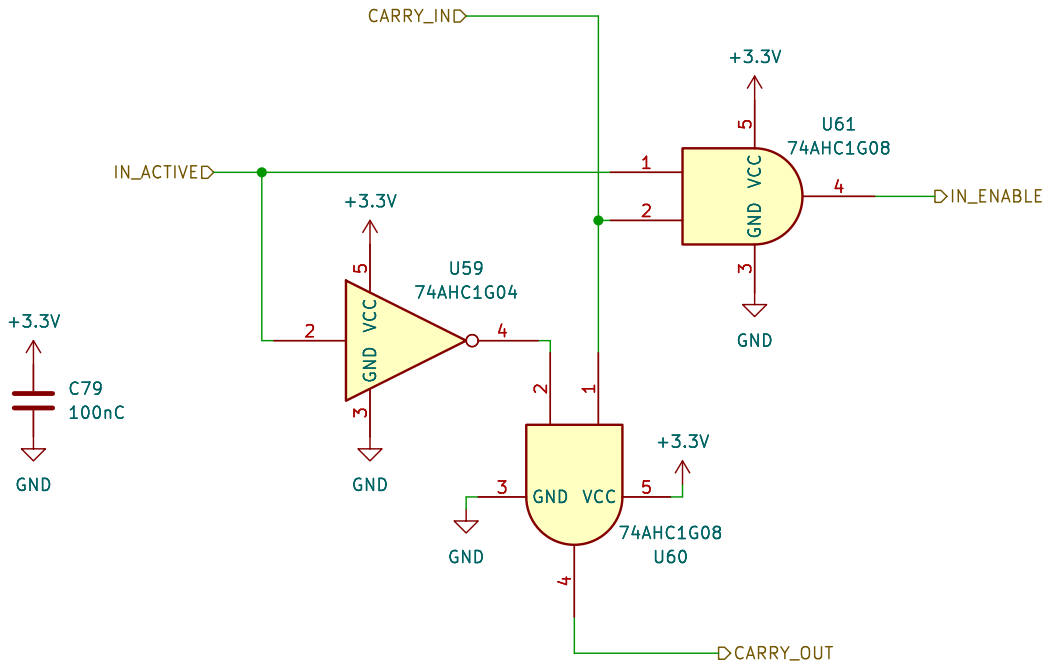
[picture p36: page 21]

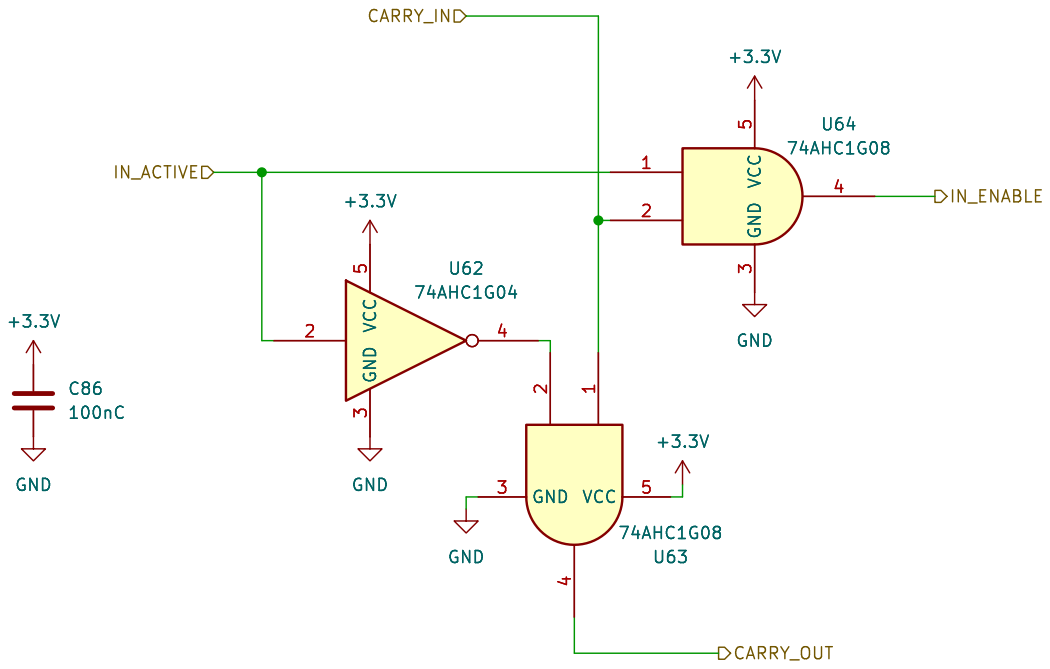
[picture p37: page 22]

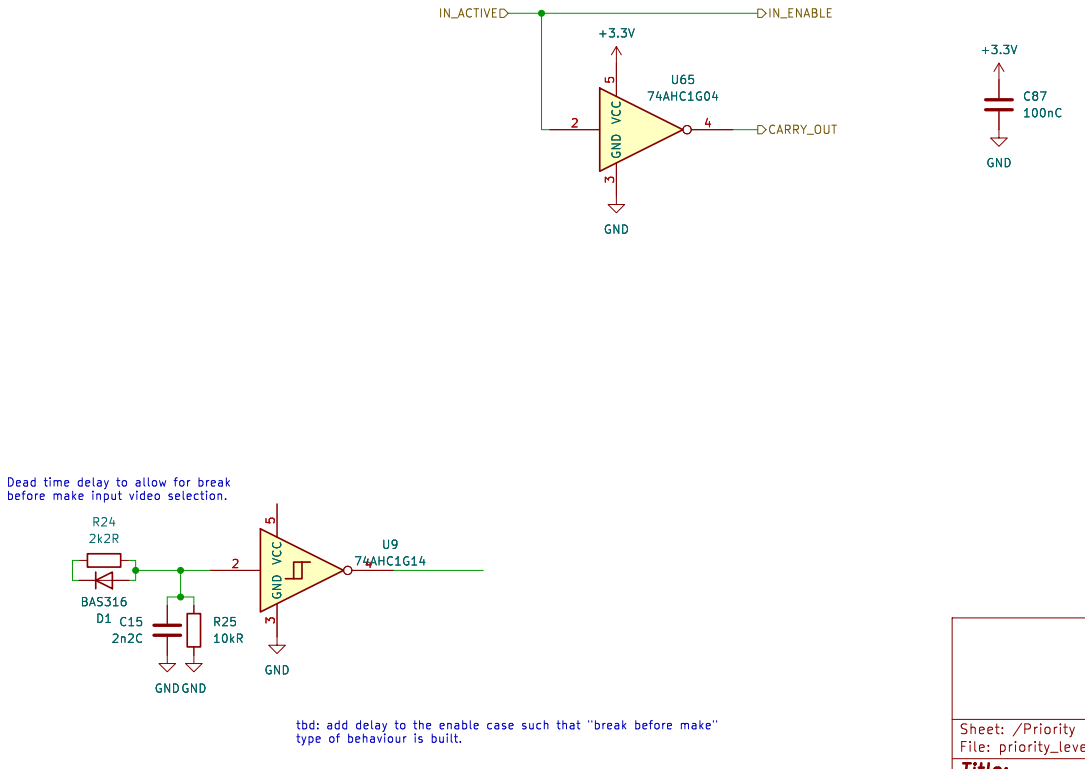
[picture p38: page 23]

tbd: add delay to the enable case such that "break before make"

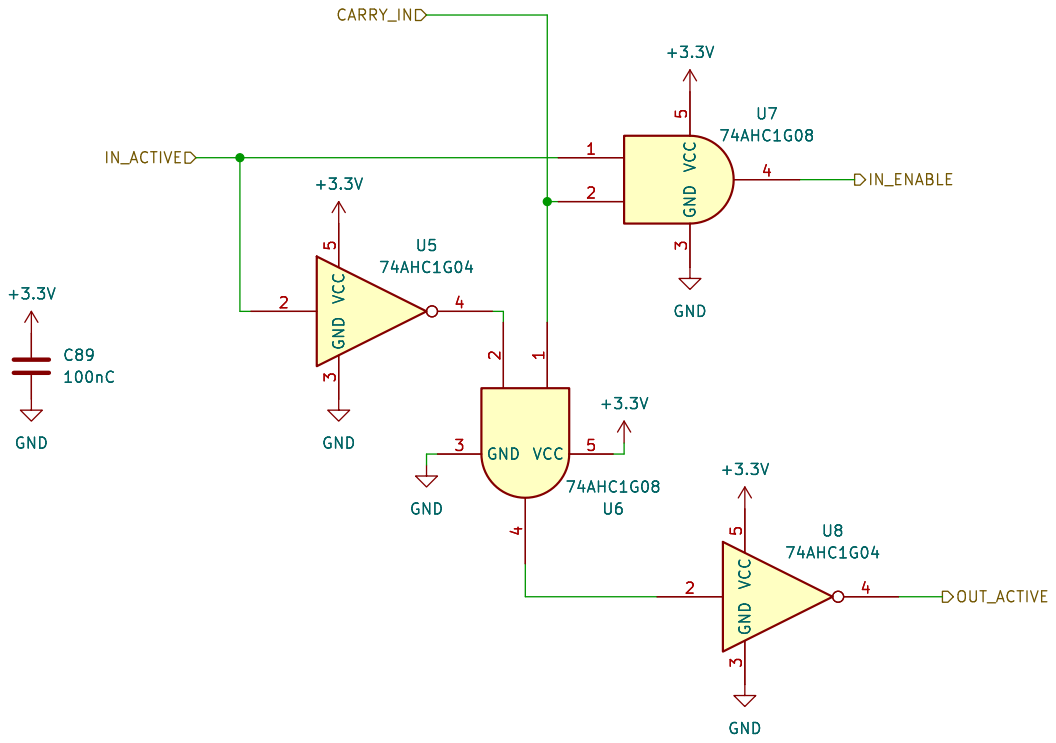
[picture p39: page 24]
