nunosousa/SCART-switcher/ECAD/SCART_switcher/FUNCTION_circuit.asc

Q1: npn; BC847A
Q2: npn; BC847A
R1: res; 3kR
R2: res; 10kR
R3: res; 10kR
R4: res; 1kR
R5: res; 4k7R
R6: res; 4k7R
V1: voltage; 12
V2: voltage; 3.3
Named nets: 0, FNC_IN1, FNC_IN2
.tran 1
