nunosousa/SCART-switcher/ECAD/SCART_switcher/Circuit simulation/LTspice/Audio_path.asc

C1: cap; 1nC
C2: cap; 22µC
C3: cap; 10µC
D1: diode; BAS16HY
J1: njf; LSK170A
Q1: npn; BC847C
Q2: npn; BC847C
R1: res; 100R
R2: res; 1kR
R3: res; 20kR
R4: res; 220kR
R5: res; 100kR
R7: res; 220kR
R8: res; 4.7kR
R9: res; 10kR
R10: res; 20kR
R11: res; 20kR
R12: res; 20kR
R13: res; 220kR
R14: res; 100R
R15: res; 10kR
R17: res; 4.7kR
R18: res; 10kR
U1: ADG1201
U3: UniversalOpAmp
U4: UniversalOpAmp
V1: voltage; SINE(0 0.7 2000)
V2: voltage; 4.5
V3: voltage; PULSE(0 5 0 0.000001 0.000001 0.002 0.004 4)
V4: voltage; 9
Named nets: 0
.tran 0.01
