nunosousa/SCART-switcher/ECAD/SCART_switcher/Circuit simulation/LTspice/BLANKING_output_circuit.asc

D1: diode; BAS16HY
Q1: pnp; BC857C
R1: res; 100R
R2: res; 10kR
R3: res; 100kR
R4: res; 4.7kR
R5: res; 4.7kR
R7: res; 75R
U1: LMV331
V1: voltage; PWL(0 0 0.99 0 1 0.4 1.99 0.4 2 0 2.99 0 3 1 3.99 1 4 0 4.99 0 5 3 5.99 3)
V2: voltage; 5
Named nets: 0, BLANKING_IN, BANLING_OUT, REF, Vcomp
.tran 6
