nunosousa/SCART-switcher/ECAD/SCART_switcher/Circuit simulation/LTspice/FUNCTION_output_circuit.asc

Q1: npn; BC847C
Q2: pnp; BC857C
R1: res; 100R
R2: res; 10kR
R3: res; 100kR
R4: res; 10kR
R5: res; 10kR
R7: res; 10kR
V1: voltage; PWL(0 0 0.9 0 1 5 1.9 5 2 0 2.9 0 3 5 3.9 5)
V2: voltage; 12
Named nets: 0, FNC_IN, FNC_OUT
.tran 4
