nunosousa/SCART-switcher/ECAD/SCART_switcher/Circuit simulation/LTspice/Source_selection.asc

D1: zener; BZX84-C3V3
D2: diode
D3: diode
Q1: npn; BC847C
Q2: npn; BC847C
Q3: npn; BC847C
Q4: npn; BC847C
Q5: npn; BC847C
Q6: npn; BC847C
Q7: npn; BC847C
Q25: npn; BC847C
Q26: npn; BC847C
R1: res; 4.7kR
R2: res; 10kR
R3: res; 10kR
R4: res; 4.7kR
R5: res; 220kR
R6: res; 10kR
R7: res; 4.7kR
R8: res; 10kR
R9: res; 10kR
R10: res; 10kR
R11: res; 4.7kR
R12: res; 4.7kR
R13: res; 10kR
R14: res; 10kR
R15: res; 4.7kR
R45: res; 10kR
R46: res; 10kR
R47: res; 4.7kR
R48: res; 4.7kR
V1: voltage; 5
V3: voltage; PWL(0 0 0.09 0 0.1 2 0.19 2 0.2 4.5 0.29 4.5 0.3 7 0.39 7 0.4 9.5 0.49 9.5 0.5 12 0.59 12)
V4: voltage; 5
Named nets: 0, FUNCTION_1, IN_ACTIVE_1, IN_ENABLE_1, CARRY_1
.tran 0.6
***********************************************************
*
* BZX84-C3V3
*
* Nexperia
*
* Voltage regulator diodes
* VFmax = 0,9V    @ IF = 10mA
* IRmax = 5µA     @ VR = 1V
* VZmax = 3,5V    @ IZ = 5mA
* IZSM  = 6A      @ tp = 100µs
*
*
*
* Package pinning does not match Spice model pinning.
* Package: SOT23
*
* Package Pin 1: Anode
* Package Pin 2: Not Connected
* Package Pin 3: Cathode
*
*
* Extraction date (week/year): #
* Simulator: PSPICE
*
***********************************************************
*
.MODEL BZX84-C3V3 D
+ IS = 7.035E-16
+ N = 0.9809
+ BV = 3.3
+ IBV = 0.005
+ RS = 0.3487
+ CJO = 3.162E-10
+ VJ = 0.6687
+ M = 0.3164
+ FC = 0.5
.ENDS
*
.inc BZX84-C3V3.lib
