nunosousa/SCART-switcher/ECAD/Power_supply/Power_supply.kicad_pcb

## KiCad design ECAD/Power_supply/Power_supply.kicad_pcb (2025-02-27)

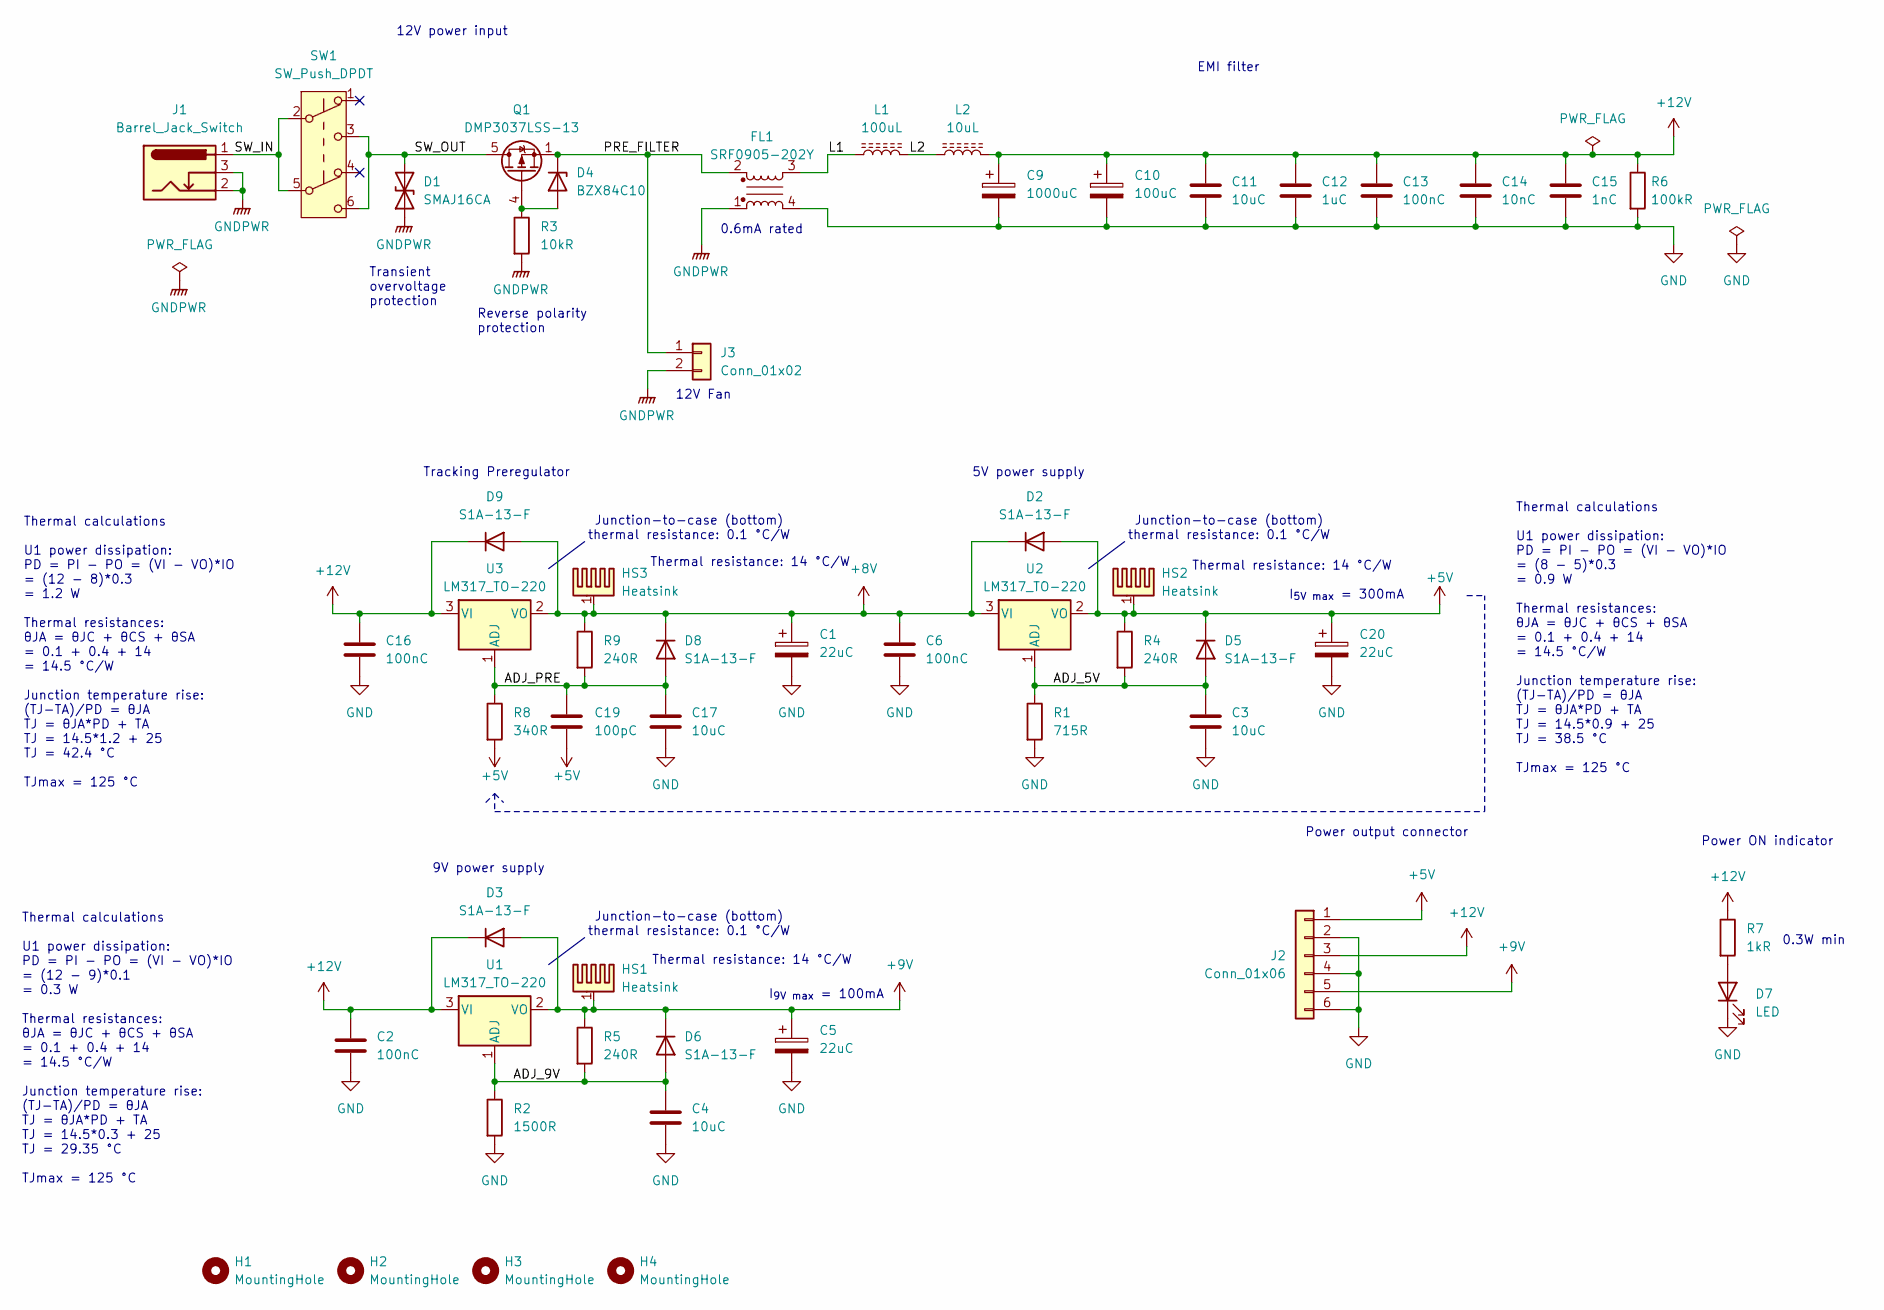
[picture p40: schematic Power_supply.kicad_sch]

Parts:
C1, C5, C20: 22uC; CP_Elec_5x5.4; MPN UWT1C220MCL1GB
C2, C6, C13, C16: 100nC; C_1206_3216Metric; MPN CC1206KRX7R9BB104
C3, C4, C11, C17: 10uC; C_1206_3216Metric; MPN CL31A106KBHNNNE
C9: 1000uC; CP_Elec_10x10.5; MPN EEEFT1E102UP
C10: 100uC; CP_Elec_8x10; MPN UWT1H101MNL1GS
C12: 1uC; C_1206_3216Metric; MPN CL31B105KBHNNNE
C14: 10nC; C_1206_3216Metric; MPN CC1206KKX7RCBB103
C15: 1nC; C_1206_3216Metric; MPN CC1206KKX7RDBB102
C19: 100pC; C_0805_2012Metric; MPN CL21C101JBANNNC
D1: SMAJ16CA; D_SMA; MPN SMAJ16CA-13-F
D2, D3, D5, D6, D8, D9: S1A-13-F; D_SMA; MPN S1A-13-F
D4: BZX84C10; SOT-23; MPN BZX84C10-7-F
D7: LED; LED_D5.0mm; MPN 333-2SURD/S530-A3
FL1: SRF0905-202Y; Filter_Bourns_SRF0905_6.0x9.2mm; MPN SRF0905-202Y
H1, H2, H3, H4: MountingHole; MountingHole_3.2mm_M3
HS1, HS2, HS3: Heatsink; Heatsink_Fischer_SK104-STC-STIC_35x13mm_2xDrill2.5mm
J1: Barrel_Jack_Switch; BarrelJack_Horizontal; MPN DC-005-20A
J2: Conn_01x06; PinSocket_1x06_P2.54mm_Vertical
J3: Conn_01x02; JST_XH_B2B-XH-A_1x02_P2.50mm_Vertical
L1: 100uL; L_Taiyo-Yuden_NR-80xx; MPN NRS8040T101MJGK
L2: 10uL; L_Taiyo-Yuden_NR-30xx; MPN NR3015T100M
Q1: DMP3037LSS-13; SOIC-8_3.9x4.9mm_P1.27mm; MPN DMP3037LSS-13
R1: 715R; R_0805_2012Metric; MPN PTFR0805B715RP9
R2: 1500R; R_0805_2012Metric; MPN RC0805FR-071K5L
R3: 10kR; R_0805_2012Metric; MPN AC0805FR-0710KL
R4, R5, R9: 240R; R_0805_2012Metric; MPN RC0805FR-07240RL
R6: 100kR; R_1210_3225Metric; MPN RC0805FR-07100KL
R7: 1kR; R_1210_3225Metric; MPN 1210W2F1001T5E
R8: 340R; R_0805_2012Metric; MPN ARG05BTC3400
SW1: SW_Push_DPDT; PN22SJNA03QE; MPN PS-22E05
U1, U2, U3: LM317_TO-220; TO-220-3_Vertical; MPN LM317KCS

Connections:
+5V: C19.2, C20.1, D2.2 (A), D5.1 (K), HS2.1, J2.1, R4.1, R8.2, U2.2 (VO)
+8V: C1.1, C6.1, D2.1 (K), D8.1 (K), D9.2 (A), HS3.1, R9.1, U2.3 (VI), U3.2 (VO)
+9V: C5.1, D3.2 (A), D6.1 (K), HS1.1, J2.5, R5.1, U1.2 (VO)
+12V: C2.1, C9.1, C10.1, C11.1, C12.1, C13.1, C14.1, C15.1, C16.1, D3.1 (K), D9.1 (K), J2.3, L2.2, R6.1, R7.1, U1.3 (VI), U3.3 (VI)
/ADJ_5V: C3.1, D5.2 (A), R1.1, R4.2, U2.1 (ADJ)
/ADJ_9V: C4.1, D6.2 (A), R2.1, R5.2, U1.1 (ADJ)
/ADJ_PRE: C17.1, C19.1, D8.2 (A), R8.1, R9.2, U3.1 (ADJ)
/L1: FL1.3, L1.1
/L2: L1.2, L2.1
/PRE_FILTER: D4.3 (K), FL1.2, J3.1, Q1.1 (S), Q1.2 (S), Q1.3 (S)
/SW_IN: J1.1, SW1.2 (B), SW1.5 (B)
/SW_OUT: D1.2 (A2), Q1.5 (D), Q1.6 (D), Q1.7 (D), Q1.8 (D), SW1.3 (C), SW1.6 (C)
GND: C1.2, C2.2, C3.2, C4.2, C5.2, C6.2, C9.2, C10.2, C11.2, C12.2, C13.2, C14.2, C15.2, C16.2, C17.2, C20.2, D7.1 (K), FL1.4, J2.2, J2.4, J2.6, R1.2, R2.2, R6.2
GNDPWR: D1.1 (A1), FL1.1, J1.2, J1.3, J3.2, R3.2
unnamed: D4.1 (A), Q1.4 (G), R3.1
unnamed: D7.2 (A), R7.2

Notes on the sheet:
Thermal resistance: 14 °C/W
12V power input
I_{5V max} = 300mA
5V power supply
Power ON indicator
12V Fan
Power output connector
I_{9V max} = 100mA
Junction-to-case (bottom) thermal resistance: 0.1 °C/W
Reverse polarity protection
0.6mA rated
0.3W min
EMI filter
Thermal calculations U1 power dissipation: PD = PI - PO = (VI - VO)*IO = (12 - 9)*0.1 = 0.3 W Thermal resistances: θJA = θJC + θCS + θSA = 0.1 + 0.4 + 14 = 14.5 °C/W Junction temperature rise: (TJ-TA)/PD = θJA TJ = θJA*PD + TA TJ = 14.5*0.3 + 25 TJ = 29.35 °C TJmax = 125 °C
Thermal calculations U1 power dissipation: PD = PI - PO = (VI - VO)*IO = (8 - 5)*0.3 = 0.9 W Thermal resistances: θJA = θJC + θCS + θSA = 0.1 + 0.4 + 14 = 14.5 °C/W Junction temperature rise: (TJ-TA)/PD = θJA TJ = θJA*PD + TA TJ = 14.5*0.9 + 25 TJ = 38.5 °C TJmax = 125 °C
9V power supply
Tracking Preregulator
Thermal calculations U1 power dissipation: PD = PI - PO = (VI - VO)*IO = (12 - 8)*0.3 = 1.2 W Thermal resistances: θJA = θJC + θCS + θSA = 0.1 + 0.4 + 14 = 14.5 °C/W Junction temperature rise: (TJ-TA)/PD = θJA TJ = θJA*PD + TA TJ = 14.5*1.2 + 25 TJ = 42.4 °C TJmax = 125 °C
Transient overvoltage protection

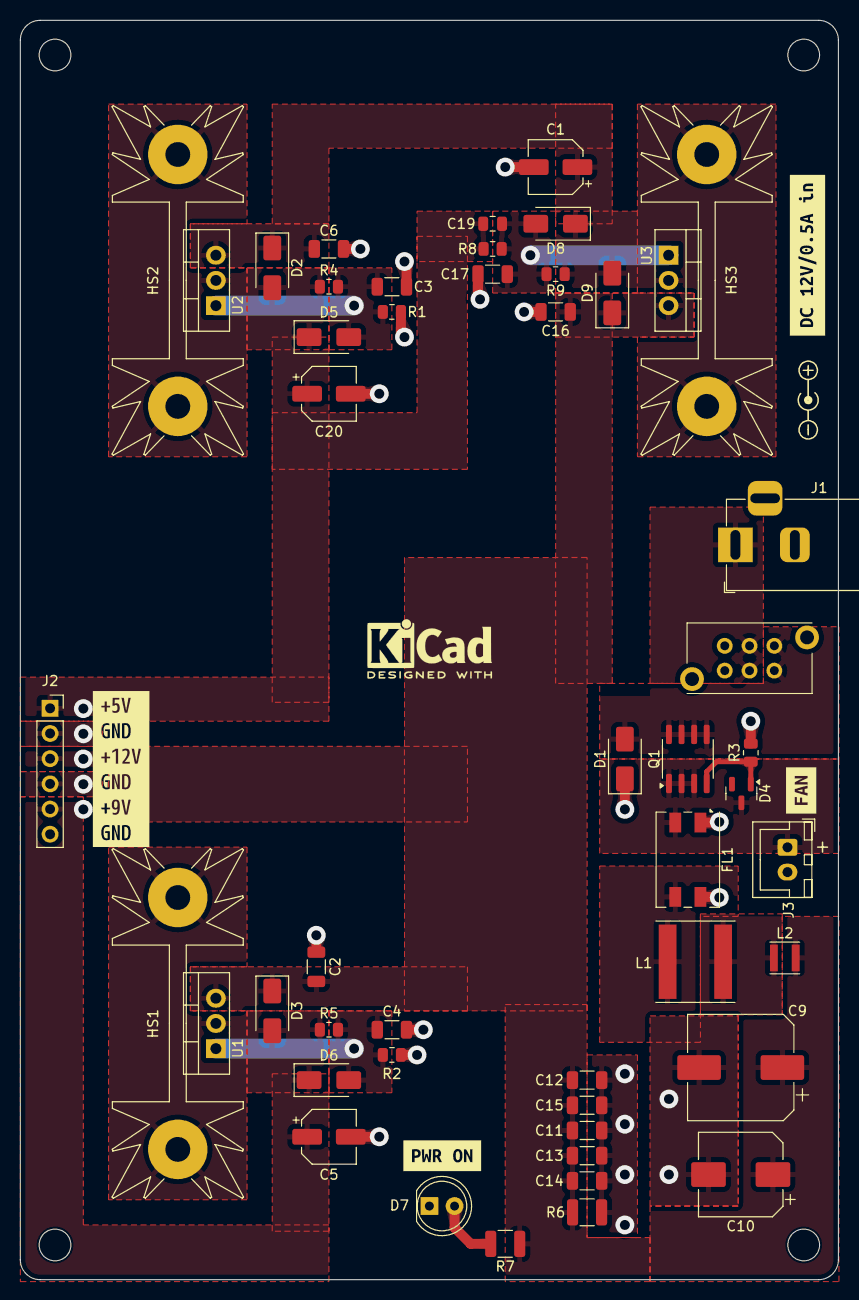
[picture p41: board Power_supply.kicad_pcb from above]

Board: 2 copper layers, 82.5 x 127.0 mm, 57 parts (0 on the bottom side), 16 nets.

Other parts of the board:
kibuzzard-67A3D3AE: G***; kibuzzard-67A3D3AE
kibuzzard-67B25D9F: G***; kibuzzard-67B25D9F
kibuzzard-67B5004D: G***; kibuzzard-67B5004D
kibuzzard-67B50421: G***; kibuzzard-67B50421
