nunosousa/SCART-switcher/ECAD/SCART_switcher/SCART_switcher.kicad_pcb

## KiCad design ECAD/SCART_switcher/SCART_switcher.kicad_pcb (2024-11-05)

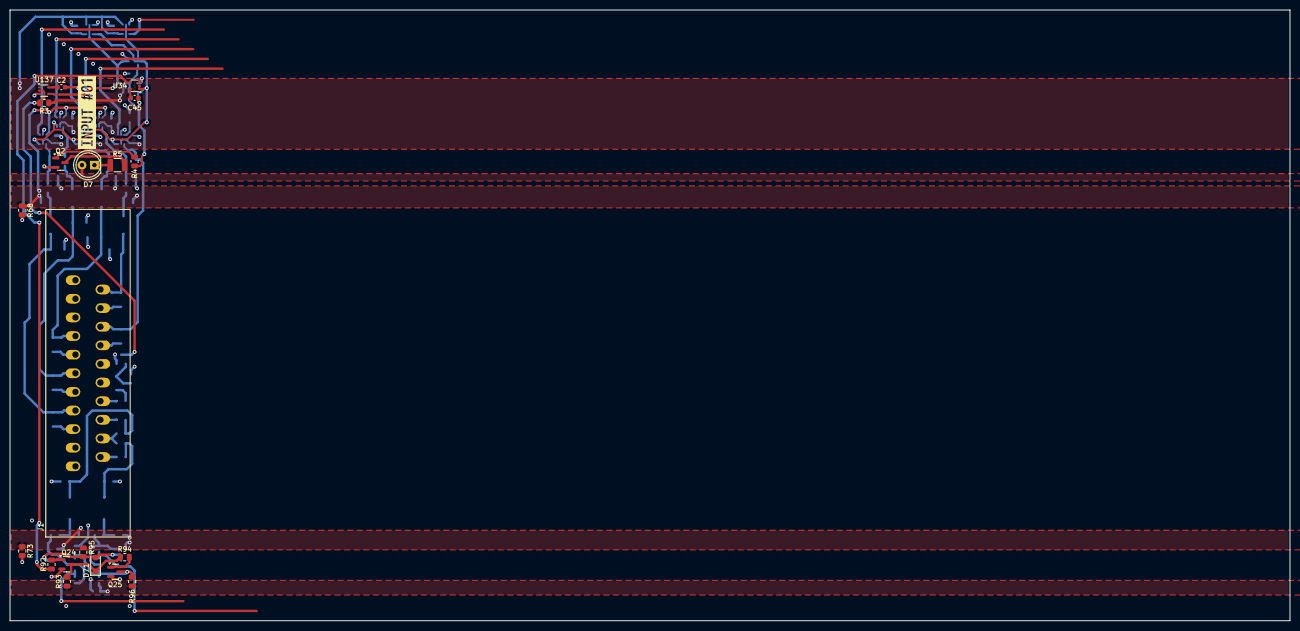
[picture p42: board SCART_switcher.kicad_pcb from above]

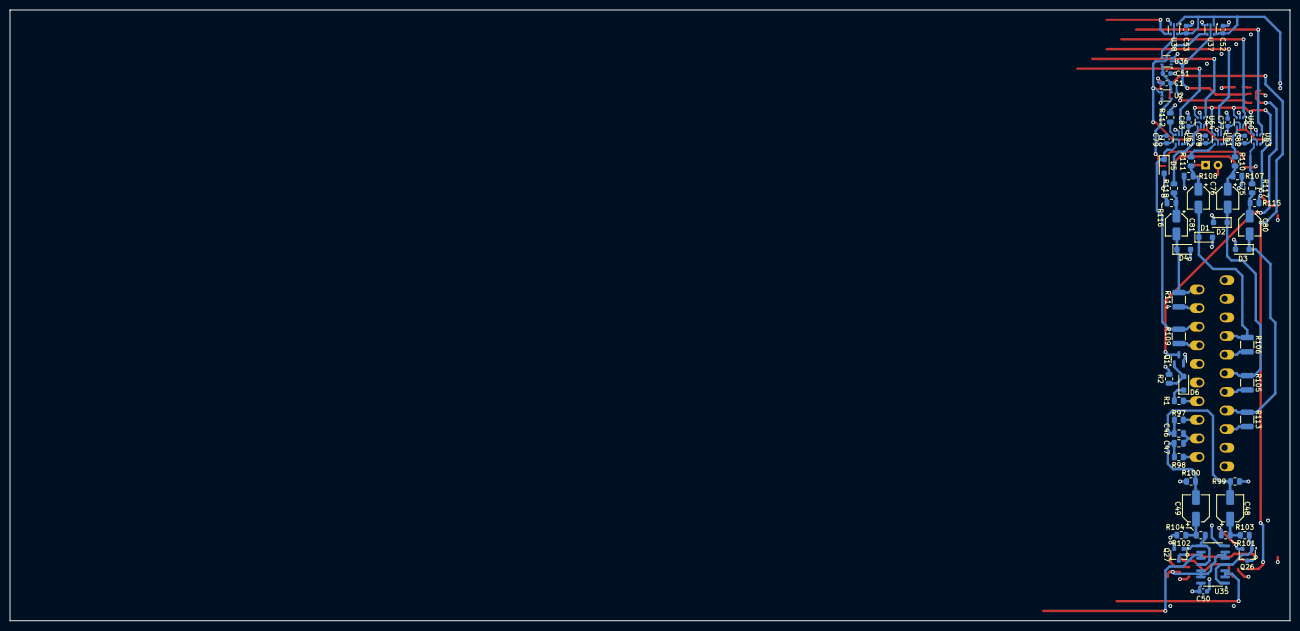
[picture p43: board SCART_switcher.kicad_pcb from below]

Board: 4 copper layers, 262.0 x 125.0 mm, 82 parts (61 on the bottom side), 46 nets.

Parts:
C1, C2, C45, C50, C51, C52, C53, C77, C78, C79, C82, C83: 100nC; C_0603_1608Metric
C46, C47: 1nC; C_0805_2012Metric
C48, C49: 22uC; CP_Elec_5x5.4
C75, C76, C80, C81: 47uC; CP_Elec_4x5.8
D1, D2, D3, D4, D5: BZT52H-B6V8; D_SOD-123F
D6: BZT52H-C3V3; D_SOD-123F
D7: LED; LED_D5.0mm
D71: BAS16H; D_SOD-123F
J1: SCART-F
Q1, Q2, Q24, Q25: BC847; SOT-23
Q26, Q27: 2SK209; SC-59
R1, R92, R94, R112: 10kR; R_0805_2012Metric
R2, R95, R99, R100: 220kR; R_0805_2012Metric
R3, R4, R93, R96: 4k7R; R_0805_2012Metric
R5: 1kR; R_1210_3225Metric
R68, R73, R110, R111, R117, R118: 1kR; R_0805_2012Metric
R97, R98: 100R; R_0805_2012Metric
R101, R102, R107, R108, R115, R116: 100kR; R_0805_2012Metric
R103, R104: 20kR; R_0805_2012Metric
R105, R106, R109, R113, R114: 75R; R_1210_3225Metric
U2, U34, U37, U38: 74LVC1G08; SOT-353_SC-70-5
U35: CD4066; SOIC-14_3.9x8.7mm_P1.27mm
U36: 74LVC1G04; SOT-353_SC-70-5
U60, U61, U62, U63, U64: 74LVC1G3157; SOT-363_SC-70-6
U137: 74LVC1G14; SOT-353_SC-70-5
kibuzzard-65C7DEEF: G***; kibuzzard-65C7DEEF

Connections:
+2V5: R68.1, R107.2, R108.2, R115.2, R116.2, U60.3, U61.3, U63.3, U64.3
+4V5: Q26.2 (S), Q27.2 (S), R73.1, R95.2, R101.2, R102.2
+5V: C1.1, C2.1, C45.1, C51.1, C52.1, C53.1, C77.1, C78.1, C79.1, C82.1, C83.1, R3.1, U2.5 (VCC), U34.5 (VCC), U36.5 (VCC), U37.1, U37.5 (VCC), U38.1, U38.5 (VCC), U60.5 (V+), U61.5 (V+), U62.5 (V+), U63.5 (V+), U64.5 (V+), U137.5 (VCC)
+9V: C50.1, R93.1, R96.1, U35.14 (V_{DD})
/AUDIO_LEFT: U35.2, U35.3
/AUDIO_RIGHT: U35.9, U35.10
/SCART input 1/AUDIO_LEFT_SCART_IN: J1.6, R97.1
/SCART input 1/AUDIO_RIGHT_SCART_IN: J1.2, R98.1
/SCART input 1/Audio input stage/AUDIO_OUT_ENABLE: Q25.3 (C), R96.2, U35.5, U35.6, U35.12, U35.13
/SCART input 1/Audio input stage/MUTE: D71.2 (A), Q26.3 (G), Q27.3 (G), R95.1
/SCART input 1/BLANKING_SCART_IN: D5.1 (K), J1.16, R109.1, U62.4
/SCART input 1/BLUE_SCART_IN: C80.2, D3.1 (K), J1.7, R113.1
/SCART input 1/FUNCTION_SCART_IN: J1.8, R1.1
/SCART input 1/GREEN_SCART_IN: C75.2, D2.1 (K), J1.11, R105.1
/SCART input 1/IN_ACTIVE: U36.2, U37.2, U137.4
/SCART input 1/IN_ENABLE: U2.1, U2.2, U34.1, U34.2, U37.4, U60.6, U61.6, U62.6, U63.6, U64.6
/SCART input 1/RED_SCART_IN: C76.2, D1.1 (K), J1.15, R106.1
/SCART input 1/VIDEO_RGB_SYNC_SCART_IN: C81.2, D4.1 (K), J1.20, R114.1
GND: C1.2, C2.2, C45.2, C46.2, C47.2, C50.2, C51.2, C52.2, C53.2, C77.2, C78.2, C79.2, C82.2, C83.2, D1.2 (A), D2.2 (A), D3.2 (A), D4.2 (A), D5.2 (A), J1.4, J1.5, J1.9, J1.13, J1.14, J1.18, J1.21, Q1.2 (E), Q2.2 (E), Q24.2 (E), Q25.2 (E), R2.2, R68.2, R73.2, R99.2, R100.2, R105.2, R106.2, R109.2, R112.2, R113.2, R114.2, U2.3 (GND), U34.3 (GND), U35.7 (V_{SS}), U36.3 (GND), U37.3 (GND), U38.3 (GND), U60.2 (GND), U61.2 (GND), U62.2 (GND), U63.2 (GND), U64.2 (GND), U137.3 (GND)
unnamed: C46.1, C48.2, R97.2, R99.1
unnamed: C47.1, C49.2, R98.2, R100.1
unnamed: C48.1, R101.1, R103.1
unnamed: C49.1, R102.1, R104.1
unnamed: C75.1, R107.1, R110.1
unnamed: C76.1, R108.1, R111.1
unnamed: C80.1, R115.1, R117.1
unnamed: C81.1, R116.1, R118.1
unnamed: D6.2 (A), Q1.1 (B), R2.1
unnamed: D6.1 (K), R1.2
unnamed: D7.1 (K), R5.1
unnamed: D71.1 (K), Q24.3 (C), R93.2, R94.1
unnamed: Q1.3 (C), R3.2, U137.2
unnamed: Q2.1 (B), R4.2
unnamed: Q2.3 (C), R5.2
unnamed: Q24.1 (B), R92.2
unnamed: Q25.1 (B), R94.2
unnamed: Q26.1 (D), R103.2, U35.1, U35.4
unnamed: Q27.1 (D), R104.2, U35.8, U35.11
unnamed: R4.1, U2.4
unnamed: R92.1, U34.4
unnamed: R110.2, U60.4
unnamed: R111.2, U61.4
unnamed: R112.1, U62.3
unnamed: R117.2, U63.4
unnamed: R118.2, U64.4
unnamed: U36.4, U38.2
