nunosousa/SCART-switcher/(commit log)

2023-08-14 First commit.
    [SCART connector (female).FCStd, SCART_input.kicad_sch, SCART_output.kicad_sch, SCART_switcher.kicad_pcb, SCART_switcher.kicad_sch]
2023-08-15 progressed cad
    [SCART connector (female)-Body.iges, SCART connector (female).FCStd]
2023-08-16 progressed ECAD
    [SCART_input.kicad_sch, SCART_output.kicad_sch]
2023-08-17 Progressed ECAD.
    [SCART_input.kicad_sch, SCART_output.kicad_sch, SCART_switcher.kicad_sch, priority_encoder.kicad_sch]
2023-08-18 progressed work
    [SCART_output.kicad_sch, SCART_switcher.kicad_sch]
2023-08-25 Created circuit simulation.
2023-08-31 Circuit simplification
    [SCART_input.kicad_sch, SCART_output.kicad_sch, SCART_switcher.kicad_sch, priority_encoder.kicad_sch]
2023-10-04 ECAD progress
    [SCART_input.kicad_sch, SCART_output.kicad_sch, power.kicad_sch, priority_level.kicad_sch, priority_level_end.kicad_sch, priority_level_start.kicad_sch]
2023-10-28 progresed ECAD
    [audio_in.kicad_sch, audio_out.kicad_sch]
2023-12-02 Create SCART connector with m holes (female).FCStd
    [SCART connector with m holes (female).FCStd]
2023-12-02 Progressed CAD/ECAD.
    [SCART connector with m holes (female)-Body.iges, SCART connector with m holes (female).FCStd]
2023-12-02 Progressed CAD.
    [SCART connector with m holes (female)-Body.iges, SCART connector with m holes (female).FCStd]
2023-12-08 ERC fixes.
    [SCART_input.kicad_sch, SCART_output.kicad_sch, SCART_switcher.kicad_sch, audio_in.kicad_sch, audio_out.kicad_sch, dummy_input.kicad_sch, power.kicad_sch, priority_level.kicad_sch]
2023-12-10 Progressed ECAD. Error fixing and cleanup.
    [SCART_input.kicad_sch, SCART_output.kicad_sch, audio_in.kicad_sch, audio_out.kicad_sch, dummy_input.kicad_sch, power.kicad_sch, priority_level.kicad_sch, priority_level_end.kicad_sch]
2023-12-22 Error fix.
    [power.kicad_sch, video_in.kicad_sch]
2023-12-28 Added separate project for input only.
    [SCART_input.kicad_sch, SCART_switcher_input.kicad_pcb, SCART_switcher_input.kicad_sch, audio_in.kicad_sch, power.kicad_sch, priority_level.kicad_sch, video_in.kicad_sch]
2024-01-14 Cleanup and new power supply pcb
    [Power_supply.kicad_pcb, Power_supply.kicad_sch, SCART_input.kicad_sch, SCART_switcher_input.kicad_pcb, SCART_switcher_input.kicad_sch, audio_in.kicad_sch, audio_out.kicad_sch, power.kicad_sch]
2024-02-24 Updated to Kicad 8.
    [SCART_input.kicad_sch, SCART_output.kicad_sch, SCART_switcher.kicad_sch, audio_in.kicad_sch, audio_out.kicad_sch, dummy_input.kicad_sch, power.kicad_sch, priority_level.kicad_sch]
2024-02-25 KiCad 8 footprint cleanup
2025-01-27 Removed 12V for LED indicator.
    [SCART_input.kicad_sch, SCART_output.kicad_sch, SCART_switcher.kicad_sch, audio_in.kicad_sch, audio_out.kicad_sch, dummy_input.kicad_sch, priority_level.kicad_sch, video_in.kicad_sch]
2025-01-27 Progressed PCB.
2025-01-28 Changed voltage reference.
    [power.kicad_sch]
2025-02-01 Updated PCB layout.
2025-02-01 Progressed PCB layout.
2025-02-02 Minor silkscreen fixes.
2025-02-04 Fixed DRC errors.
    [power.kicad_sch]
2025-02-04 Completed PCB layout.
    [SCART_switcher.kicad_sch]
2025-02-05 Minor updates to PCB.
2025-02-05 Generated Gerber files.
    [SCART_switcher-B_Cu.gbl, SCART_switcher-B_Mask.gbs, SCART_switcher-B_Paste.gbp, SCART_switcher-B_Silkscreen.gbo, SCART_switcher-Edge_Cuts.gm1, SCART_switcher-F_Cu.gtl, SCART_switcher-F_Mask.gts, SCART_switcher-F_Paste.gtp]
2025-02-07 Added mounting holes to PCB.
    [SCART_switcher-B_Cu.gbl, SCART_switcher-B_Mask.gbs, SCART_switcher-B_Paste.gbp, SCART_switcher-B_Silkscreen.gbo, SCART_switcher-Edge_Cuts.gm1, SCART_switcher-F_Cu.gtl, SCART_switcher-F_Mask.gts, SCART_switcher-F_Paste.gtp]
2025-02-07 Thermal calculations.
    [Power_supply.kicad_sch]
2025-02-08 Updated the schematic.
    [Power_supply.kicad_pcb, Power_supply.kicad_sch]
2025-02-12 Updated schematic
    [Power_supply.kicad_sch]
2025-02-16 Improved layout.
    [Power_supply.kicad_pcb]
2025-02-16 Progressed PCB
    [Power_supply.kicad_pcb, Power_supply.kicad_sch]
2025-02-16 Added heatsink 3D model.
    [Power_supply.kicad_pcb, Power_supply.kicad_sch, sk_104_25.4_stc.igs, sk_104_25.4_stic.igs]
2025-02-18 Added Fan.
    [Power_supply.kicad_pcb]
2025-02-19 Minor tweeks.
    [Power_supply.kicad_pcb]
2025-02-22 BOM updates.
    [BOM.csv, LM4041.xlsx, Power_supply.kicad_pcb, Power_supply.kicad_sch, power.kicad_sch]
2025-02-22 BOM fixes.
    [BOM.csv, Power_supply.kicad_sch, audio_in.kicad_sch, audio_out.kicad_sch, power.kicad_sch, video_in.kicad_sch, video_out.kicad_sch]
2025-02-22 BOM fixes
    [BOM.csv, Power_supply.kicad_sch, SCART_input.kicad_sch]
2025-02-23 Updated output files.
    [BOM.csv, Power_supply-BOM.csv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]
2025-02-24 Minor change.
    [Power_supply-B_Cu.gbl, Power_supply-B_Mask.gbs, Power_supply-B_Paste.gbp, Power_supply-B_Silkscreen.gbo, Power_supply-Edge_Cuts.gm1, Power_supply-F_Cu.gtl, Power_supply-F_Mask.gts, Power_supply-F_Paste.gtp]
2025-02-25 Fix alignment mistake.
    [Power_supply-B_Cu.gbl, Power_supply-B_Mask.gbs, Power_supply-B_Paste.gbp, Power_supply-B_Silkscreen.gbo, Power_supply-Edge_Cuts.gm1, Power_supply-F_Cu.gtl, Power_supply-F_Mask.gts, Power_supply-F_Paste.gtp]
2025-02-27 Minor alignment fix.
    [Power_supply-B_Cu.gbl, Power_supply-B_Mask.gbs, Power_supply-B_Paste.gbp, Power_supply-B_Silkscreen.gbo, Power_supply-Edge_Cuts.gm1, Power_supply-F_Cu.gtl, Power_supply-F_Mask.gts, Power_supply-F_Paste.gtp]
2025-02-27 CAD redo
2025-02-28 Updated CAD.
    [5mm standoff.FCStd]
2026-11-09 Expanded README.md with detailed project description, design overview, repository contents, viewing instructions, board previews, existing design outputs, and fabrication guidelines.
